m-zeybek/DPC-Hardware-Project/README.md

# DPC-Hardware-Project
EE464 Hardware Project Repo
