m-zeybek/DPC-Hardware-Project/Final Report/main.tex

\documentclass{article}

\usepackage{amsmath}
\usepackage{natbib}
\usepackage{graphicx}
\usepackage{siunitx}
\usepackage{float}
\usepackage{hyperref}
\newcommand\tab[1][1cm]{\hspace*{#1}}
\date{} 
\begin{document}

\begin{figure}[!tp]
\vspace{-10mm}
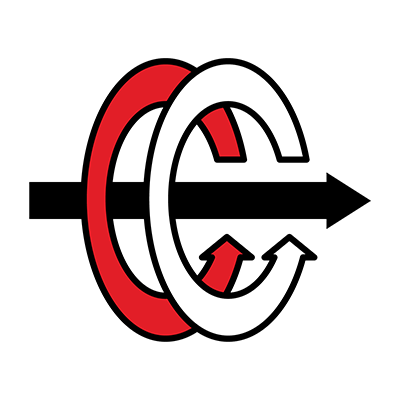
[picture p1: Final Report/ee.png]


\vfil
\hfil \Large \bf MIDDLE EAST TECHNICAL UNIVERSITY
 \hfil
\vfil

\vspace{5mm}
\vfil
\hfil \large \bf  EE464- STATIC POWER CONVERSION-II
 \hfil
\vfil

\vspace{5mm}
\vfil
\hfil \large \bf HARDWARE PROJECT FINAL REPORT \hfil
\vfil
\bf

\vspace{23mm}
Mert ZEYBEK    \tab\tab 2167682

Hamza SOLAK \tab\tab2263762

\vspace{5mm}
\small Date: 24/06/2020

\end{figure}

\newpage

\tab\tab
\section*{Introduction}
\tab In this project, we aimed to design a regulated and isolated DC-DC power supply using Forward Converter topology. This report contains detailed simulation results of our Forward Converter design, PCB design and 3D view of this design, component selection, bill of materials of component selection and thermal equivalent circuit of our design is provided. Basic circuitry and specifications of the Forward Converter is given below:
\begin{figure}[h]
    \centering
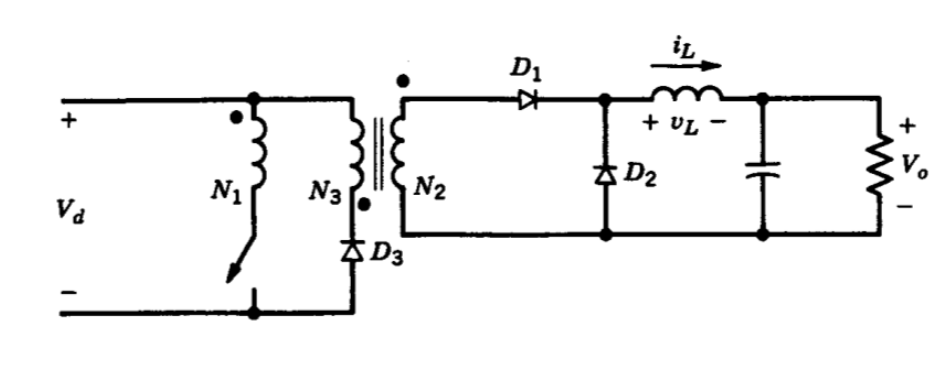
[picture p2: Final Report/forwardconverter.PNG]
    
    \caption{Forward converter circuit schematic }
    \label{fig:my_label}
\end{figure}

\begin{center}
Table 1: Project Design Specifications of Forward Converter
\newline \\

 \begin{tabular}{||c c||} 
 \hline
 Minimum Input Voltage & 12V \\ 
 \hline
 Maximum Input Voltage & 24V  \\
 \hline
 Output Voltage & 10V  \\
 \hline
 Output Power & 48 W  \\
 \hline
 Output Voltage Peak to Peak Ripple & 2 \% \\
 \hline
  Line Regulation & 2 \% \\
 \hline
  Load Regulation & 2 \% \\
 \hline
 \end{tabular}
 \end{center} \\
 
 \tab Considering that using Forward Converter topology instead of Flyback Converter increases cost, we aimed to come up with a more efficient converter instead of cheaper converter since using this topology already increases cost and it may not be possible to offer cheapest solution to the customers. Minimizing volume also was not our primary concern since the topology has transformer which makes its volume larger than non-isolated converter topologies such as Buck converter, Cuk converter.
 
\newpage
\section*{Design Decisions}
\tab Since we aim to make our circuit as efficient as possible, some of the design decisions that we took in the Simulation Report are revised. We tried to make core loss and copper loss of magnetizing elements as close as possible since we assume it is the ideal and most efficient case. Semiconductor devices are also revised to minimize losses on them.
\subsection*{1) Magnetic Design}
\tab\textbf{a) Transformer Design} \\
\tab Firstly, we selected our switching frequency. We selected it as 10 kHz. Although it is relatively small value for that kind of application, it decreases losses which is our main goal. Then we calculated our desired area product for the transformer considering our design specifications as follows, where $P_{out}$ is output power, J is current density, K is topology constant, $B_{max}$ is maximum flux density and f is frequency:

 \begin{equation*}
     W_aA_c=\frac{P_{out}J}{K B_{max} f}=\frac{48*500}{0.0005*1300*10*10^3}=3.69 cm^4
 \end{equation*}
 \tab Since we desire to have a high permeability core for Forward Converter, ferrite cores fit better for our application. Considering these, \href{https://www.mag-inc.com/Media/Magnetics/Datasheets/0P44022EC.pdf}{0P44022EC} is selected. It is an E shaped, P material type ferrite core, whose area product is $4.59 cm^4$. Its geometric shape is given below:
 \begin{figure}[H]
    \centering
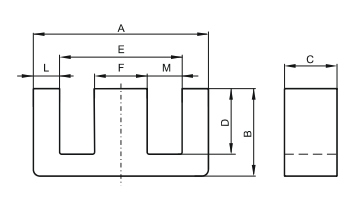
[picture p3: Final Report/transformer.PNG]
    
    \caption{Geometric Shape of Transformer Core}
    \label{fig:my_label}
\end{figure}
 \tab After that, we calculated our required primary number of turns for the transformer as follows:
 \begin{equation*}
    n_1>\frac{V_i_{max}*D_{max}}{f_s*B_{sat}*A_e}=\frac{24*0.5}{10^4*0.3*0.000233}=17.167
\end{equation*}
$n_1$ is selected as 18. Considering we always need to stay below 0.5 duty cycle so that we do not saturate the core and considering additional voltage losses in realistic simulation, we calculated $n_3$ $ \frac{n_3}{n_1}=1.2$. As a result, $n_3$ is initially selected as 22. On the other hand, later simulation results with non-idealities showed that this turn ratio causes duty cycle to go over 0.5 in minimum input voltage, 24 V. As a result, it is adjusted as 40, according to simulation results. $n_2$ is selected as 18 as well, equal to $n_1$. After that, appropriate cable sizes are selected for each winding for current density of $4 A/mm^2$. Maximum input current is assumed to be 2.08 A and output current is assumed to be 5 A considering power and voltage ratings. As a result, AWG18 for primary side, AWG14 for secondary side and AWG25 for reset winding is selected. Fill factor is calculated to whether we can fit these cables inside the core or not as follows:
\begin{equation*}
    k_f=\frac{A_{cable}}{A_e}=\frac{((18*0.82+39*2.08+18*0.16) mm^2}{233 mm^2}=0.424
\end{equation*}
Fill factor is relatively small, on the other hand it shows that cables can fit into the core and having a large core can help us reduce core losses. \\
\tab Copper losses are calculated with selected cable sizes. To do that, mean length per turn value was necessary, which is calculated as below for E shaped transformer:
\begin{equation*}
    MLT=\frac{ \pi*(E-F)}{4}= 13.59 mm
\end{equation*}

After that, primary and secondary winding resistances are found as follows:

\begin{equation*}
    R_{1}=20.9428*18*13.59*10^{-6}=5.123 mOhms
\end{equation*}

\begin{equation*}
    R_{3}=8.282*40*13.59*10^{-6}=4.502 mOhms
\end{equation*}

Using $I^2R$ formula, copper loss is calculated as follows:
\begin{equation*}
    P_{copper}=I_1^2R_1+I_3^2R_3=2.08^2*5.123*10^{-3}+5^2*4.502*10^{-3}=134 mW
\end{equation*}

\tab To calculate core loss, Steinmetz's Equation is used. It is specified as follows:
\begin{equation*}
    P_{CL}=\frac{a*f^x*B^y*L(T)}{1000} mW/cm^3
\end{equation*}
\tab To use this equation, a, x and y constants, which are material specific, are needed. For P type material Magnetics provided these values as $a=3.2$, $x=1.46$ and $y=2.75$. L(T) is also a function of ambient temperature and it is given as $1$ for $100 Celcius$ temperature. It is assumed to be 1 in the calculation:
\begin{equation*}
     P_{CL}=\frac{3.2*(10*10^3)^{1.46}*0.3^2.75}{1000}=137.91 mW/cm^3
\end{equation*}
Multiplying it with $V_e$ of the core which is $5590 mm^3$, we can find $P_{core}$ as follows:

\begin{equation*}
   P_{core}=P_{CL}*V_e=137.91*5.59=770.92 mW
\end{equation*}

\tab Lastly, to find magnetizing inductance of the transformer, following equation is used:

\begin{equation*}
    L_m=A_L N^2=5000 nH*(40+18*2)^2=28.88 mH
\end{equation*}

\tab\textbf{b) Inductor Design}
\newline \tab At inductor design, we want to limit output current ripple which would also ensure continuous conduction mode. We want to keep the converter in CCM since forward converter's gain changes a lot in DCM. On the other hand, choosing a too large inductor would increase DCR value, which would reduce efficiency. We considered following equations for calculation of our output inductor considering 2 \% ripple rating:
\begin{equation*}
    I_{L_O,min}=I_{O,max}*0.02 =4.8*0.02=0.096 A
\end{equation*}
Ripple value must be less than twice of this value which is given below:
\begin{equation*}
{\displaystyle \Delta }I_{L_o}=(\frac{n_3}{n_1}*V_i-V_o)*\frac{1}{L_o}*t_{on}<0.192 A
\end{equation*}
\tab As a result, we need an inductor with $3.8 mH$ inductance in order to meet criteria. This value is relatively high since our switching frequency is small. As a result, we needed to select a core with high inductance per turn square value. Using \href{https://www.mag-inc.com/getattachment/Products/Ferrite-Cores/Learn-More-about-Ferrite-Cores/Magnetics-Ferrite-Catalog-2017.pdf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}{this} catalog of Magnetics, \href{https://www.mag-inc.com/Media/Magnetics/Datasheets/0W44715TC.pdf}{0W44715TC} is selected as our inductor core. Its geometric shape is given below:
\begin{figure}[H]
    \centering
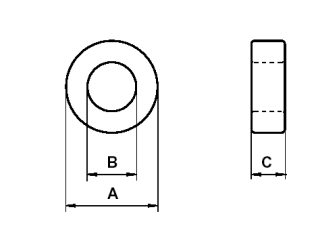
[picture p4: Final Report/inductor.PNG]
    
    \caption{Geometric Shape of Inductor Core}
    \label{fig:my_label}
\end{figure}
Its $A_L$ value is defined as $16100 nH/T^2$ at 10 kHz, which is our switching frequency. Number of turns is calculated as follows:
\begin{equation*}
    N=10^3*\sqrt\frac{L}{A_L}=10^3*\sqrt\frac{3.8 mH}{16100 nH}=15.36 \approx 16 turns
\end{equation*}
Assuming it will carry more or less same amount of current with the secondary winding of the transformer, we can choose AWG14 cable for inductor as well.Fill factor according to these selection is calculated below:
\begin{equation*}
    K_f=\frac{A_{cond}}{W_a}=\frac{2.08*16}{145}=0.230
\end{equation*}
After that, length of cable that is going to used for inductor is necessary to determine copper loss on the inductor. 

\begin{equation*}
    MLT=(A-B)+2C=49.9 mm
\end{equation*}

\begin{equation*}
    P_{copper}=I^2R=4.8^2*8.282*16*49.9*10^{-6}=317 mW
\end{equation*}
\tab To find core losses, Steinmetz's Equation is used once more.  According to that, core loss is calculated below:
\begin{equation*}
    P_{core}=V_e*a*B^b*f^c=16.063*10^{-3}*31.320*0.3^{1.585}*40^{1.371}=44.26 mW
\end{equation*}
\subsection*{2) Closed Loop Control}
\tab Since we desire to have a constant output voltage with variable input voltage, we need to have a closed loop controller. To do that, we used TL494 integrated circuit. Its pin output is given below:

\begin{figure}[H]
    \centering
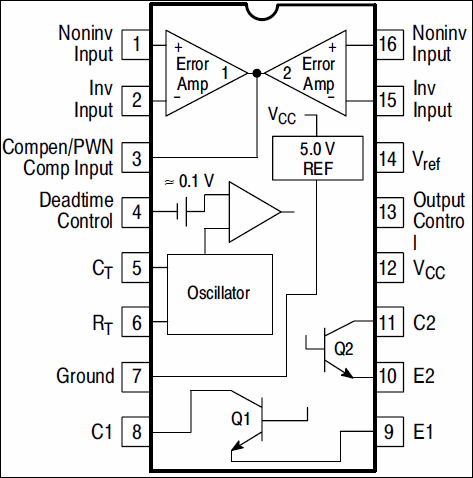
[picture p5: Final Report/tl494.png]
    
    \caption{TL494 Pin Output Diagram}
    \label{fig:my_label}
\end{figure}

\tab First thing to do while deciding our parameters was setting oscillation frequency equal to our selected switching frequency, which is 10 kHz. $R_T$ and $C_T$ values are calculated according to the following formula:

\begin{equation*}
    f_s=\frac{1}{R_TC_T}
\end{equation*}
$C_T$ is selected as 1 nF and $R_T$ is selected as 100 kOhms.  \\
After that, we moved to Error Amplifier circuit in order to keep output voltage constant, whose schematic is given below:

\begin{figure}[H]
    \centering
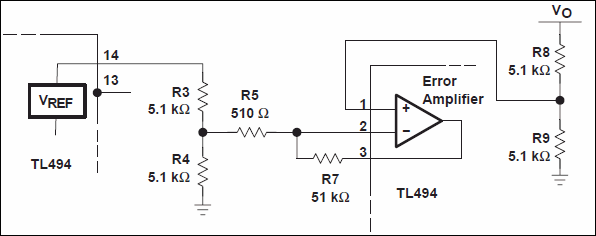
[picture p6: Final Report/error.png]
    
    \caption{TL494 Error Amplifier Circuit}
    \label{fig:my_label}
\end{figure}

\tab In this circuitry, $R_3$ and $R_4$ resistances create a reference voltage of 2.5 V. $R_8$ and $R_9$ enables us to sample our output voltage and $R_5$ and $R_7$ determines the gain of the amplifier. We decided to stick to resistance values that were given in the example circuit given above, since they meet our requirements. From the TL494 schematic, we can see that there are two error amplifiers in this circuit. However, the other amplifier is usually used for current limiting, which we do not want to have in this case. As a result, we decided to connect its positive input to supply voltage and negative input to ground, so that we never limit the current. \\

\tab After that, we moved on to soft start future of TL494, which can be helpful in limiting stresses on the devices by avoiding high starting currents. Soft start circuit of TL494 is given below:

\begin{figure}[H]
    \centering
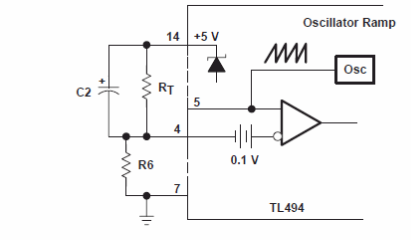
[picture p7: Final Report/soft.PNG]
    
    \caption{TL494 Soft Start Circuit}
    \label{fig:my_label}
\end{figure}

\tab Soft start time is selected as 15 ms, which is 150 cycles period for 10 kHz frequency. According to that, $C_2$ is selected as 3.3 uF AND $R_6$ is selected as 4.7 kOhms. \\

\tab TL494 is good at creating the PWM signal that we desire. However, it cannot drive a MOSFET directly with its output signal. Considering this, we decided to use an TLP250 digital optocoupler. It also creates isolation between high voltage part and low voltage part of the circuit, which is another advantage. TLP250 circuit is given below:

\begin{figure}[H]
    \centering
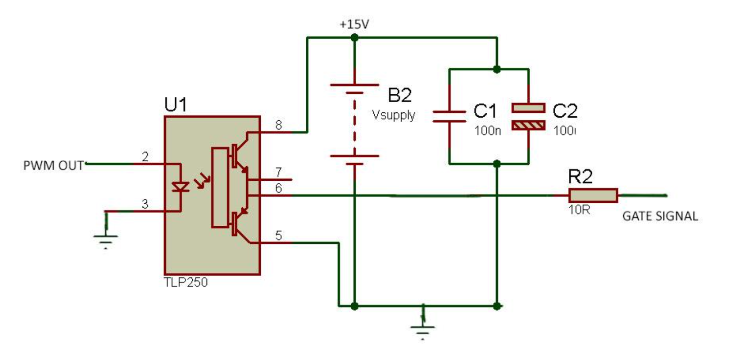
[picture p8: Final Report/opto.PNG]
    
    \caption{TLP250 Digital Optocoupler Circuit}
    \label{fig:my_label}
\end{figure}
\tab We needed an another optocoupler in order to isolate output from the controller circuit. We decided to use TLP521 for this purpose. Its pin diagram is given below:
\begin{figure}[H]
    \centering
    
    \caption{TLP521 Analog Optocoupler Pin Diagram}
    \label{fig:my_label}
\end{figure}

\newpage
\section*{Simulation Results and Component Selections}
\tab Component selection that was done in the Simulation Report is revised since it was based on ideal Forward Converter Simulink model and hence voltage and current ratings of the components were too strict. As a result, new components are selected with higher ratings and their characteristics are put in the non-ideal Simulink model. Calculated magnetizing inductance and leakage inductance of the transformer, resistances of the windings, voltage drops on the semiconductors, resistance of the inductor and capacitor are added to the model and stress on the components are checked once again in order to verify that components can operate properly in the circuit. Simulink model of the converter is given below:
\begin{figure}[H]
    \centering
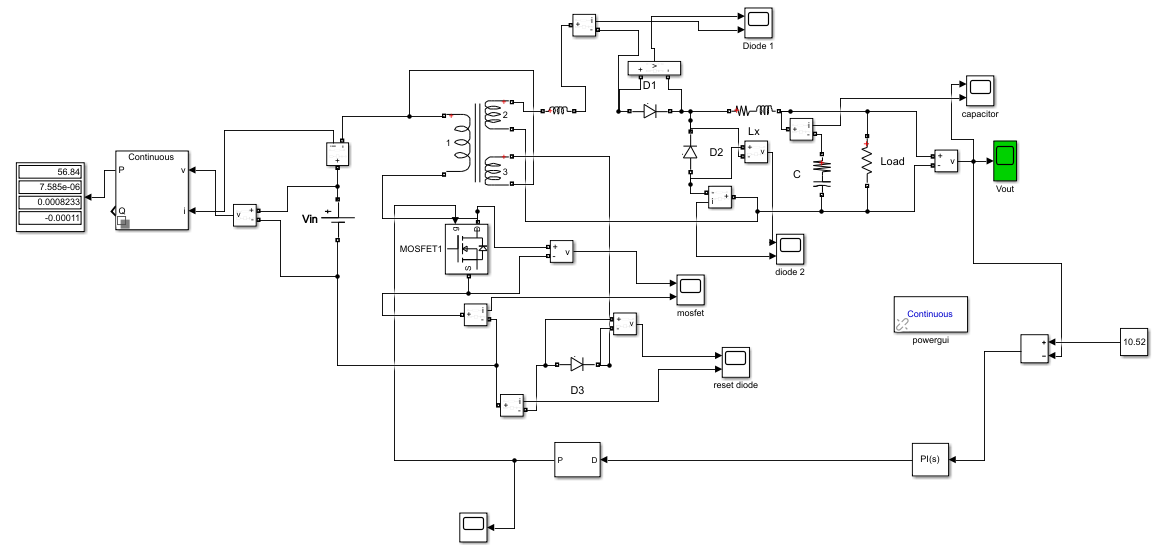
[picture p9: Final Report/non ideal simulink.PNG]
    
    \caption{Simulink Model of the Forward Converter with Non-Idealities}
    \label{fig:my_label}
\end{figure}
\tab The circuit is simulated for two extreme cases, having 24 V input and 48 V input. Output voltage waveform for these cases are given below:
\begin{figure}[H]
    \centering
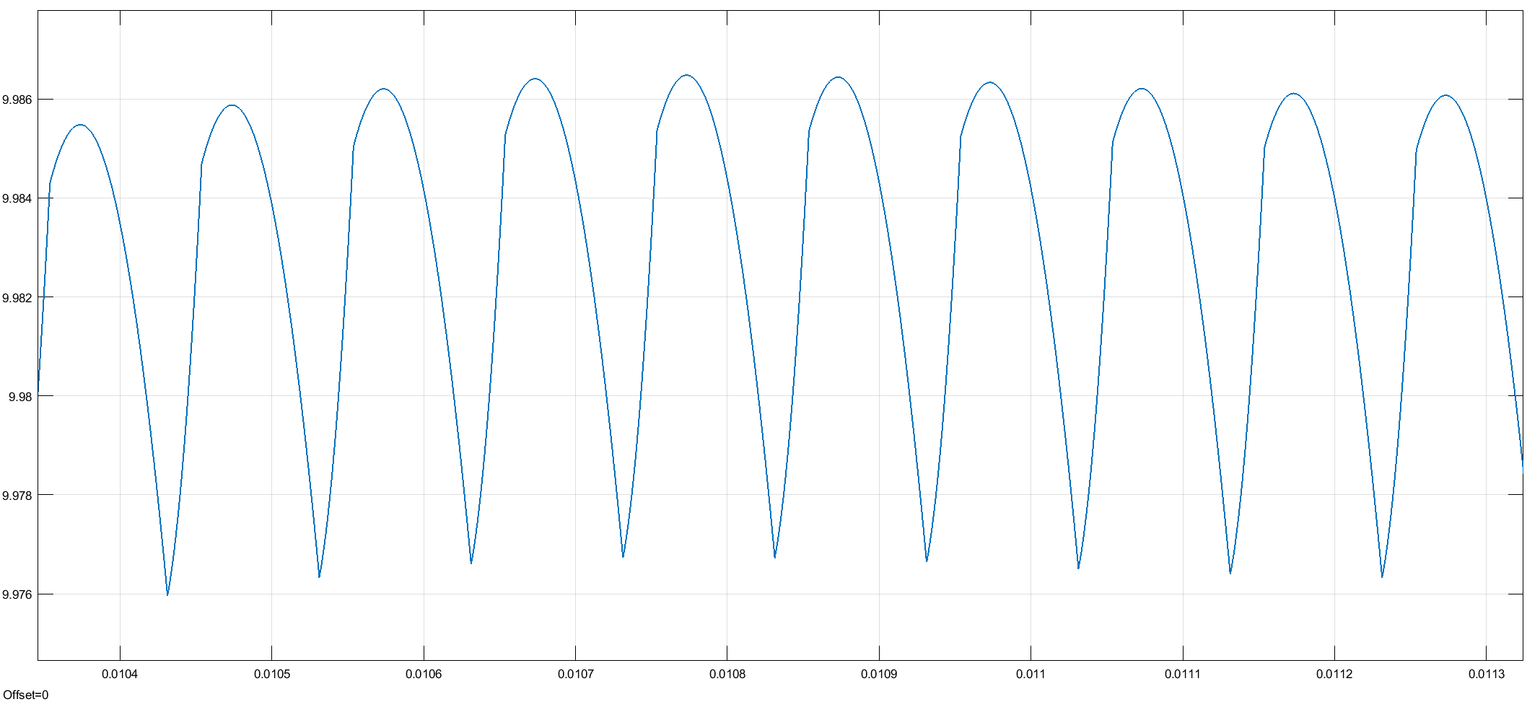
[picture p10: Final Report/24v_output.png]
    
    \caption{Output Voltage Waveform when Input Voltage is 24 V}
    \label{fig:my_label}
\end{figure}

\begin{figure}[H]
    \centering
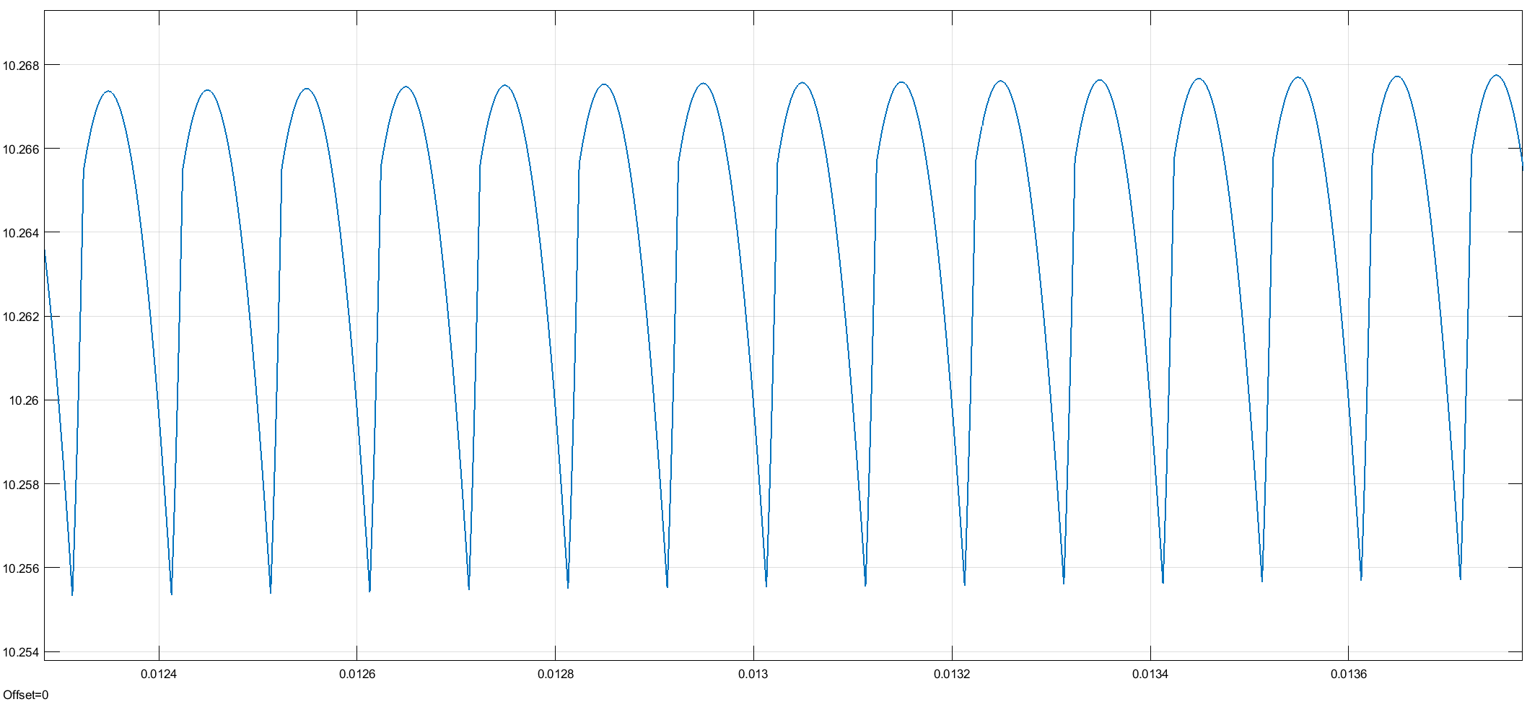
[picture p11: Final Report/48v_output.png]
    
    \caption{Output Voltage Waveform when Input Voltage is 48 V}
    \label{fig:my_label}
\end{figure}
\tab For 24 V input, peak to peak voltage ripple is 0.0101 V, which corresponds to $0.1 \%$ and it is 0.01242 V for 48 V input which is also very close to $0.1 \%$ ripple percentage, easily meeting the criteria. 

\tab Input current waveforms are also given for both input voltage cases below:
\begin{figure}[H]
    \centering
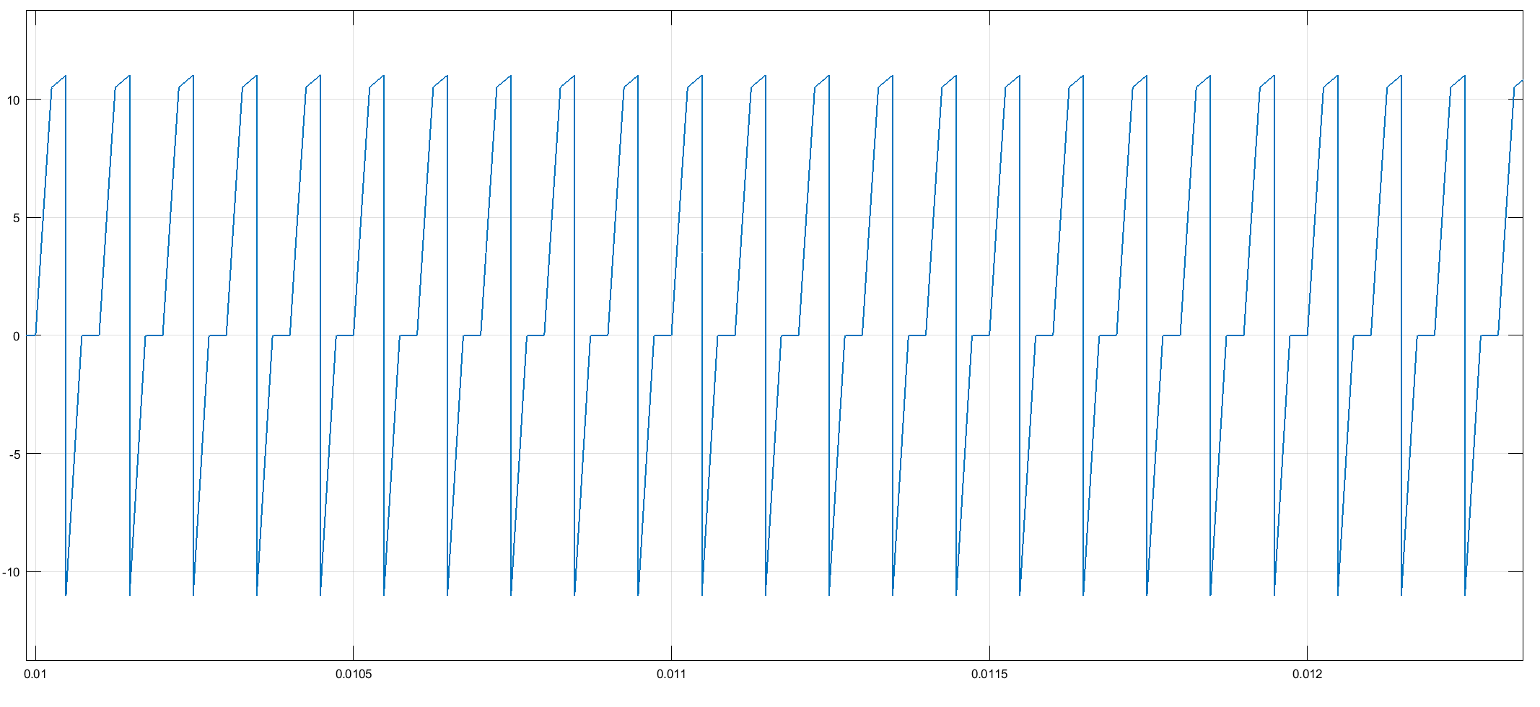
[picture p12: Final Report/24v_input current.png]
    
    \caption{Input Current Waveform when Input Voltage is 24 V}
    \label{fig:my_label}
\end{figure}

\begin{figure}[H]
    \centering
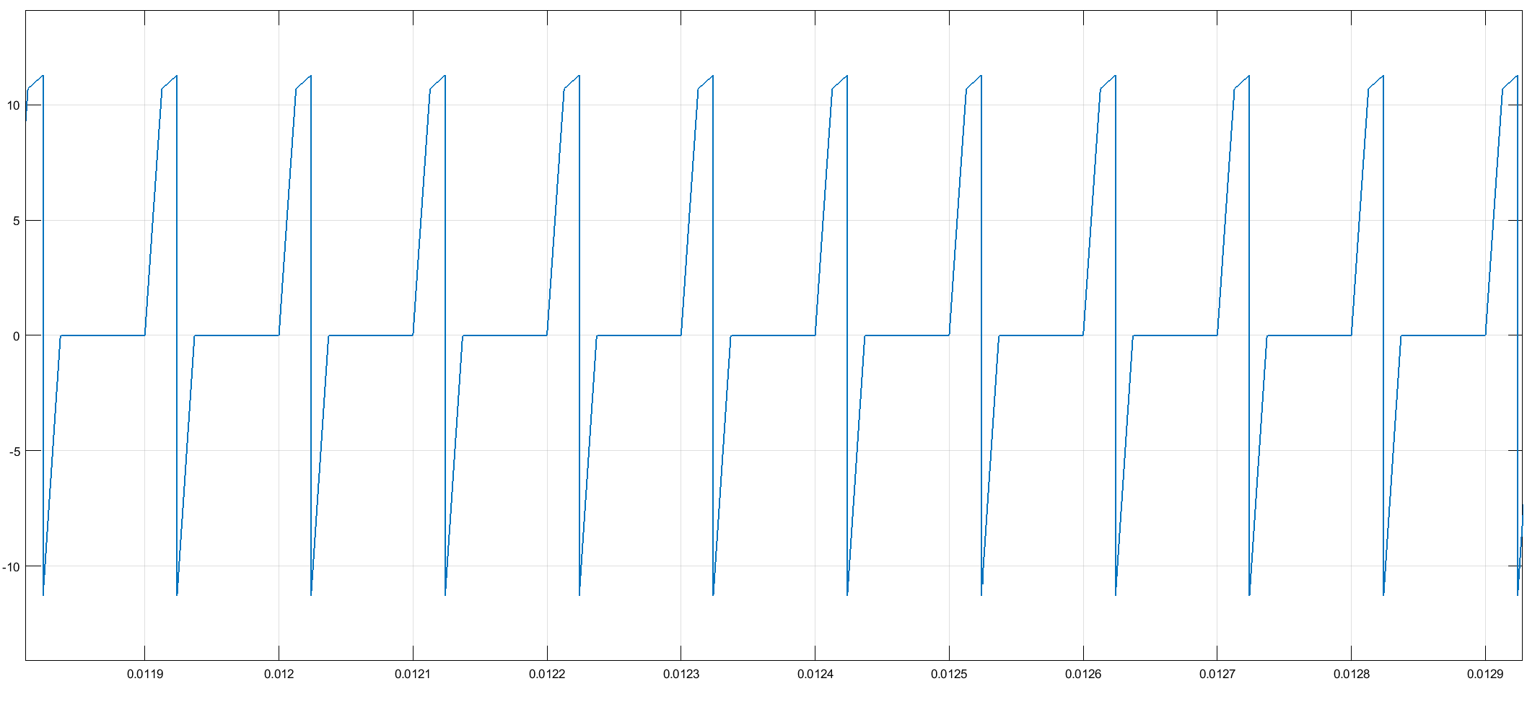
[picture p13: Final Report/48v_input current.png]
    
    \caption{Input Current Waveform when Input Voltage is 48 V}
    \label{fig:my_label}
\end{figure}

\tab After that, load resistance is changed from 2.08 Ohms to 20.8 Ohms to check voltage deviation with respect to previous case with 24 V input. It could not be done dynamically, changing resistance during the simulation, since variable resistor is not included in Power Systems library in Simulink. Output voltage waveform for this case is given below:
\begin{figure}[H]
    \centering
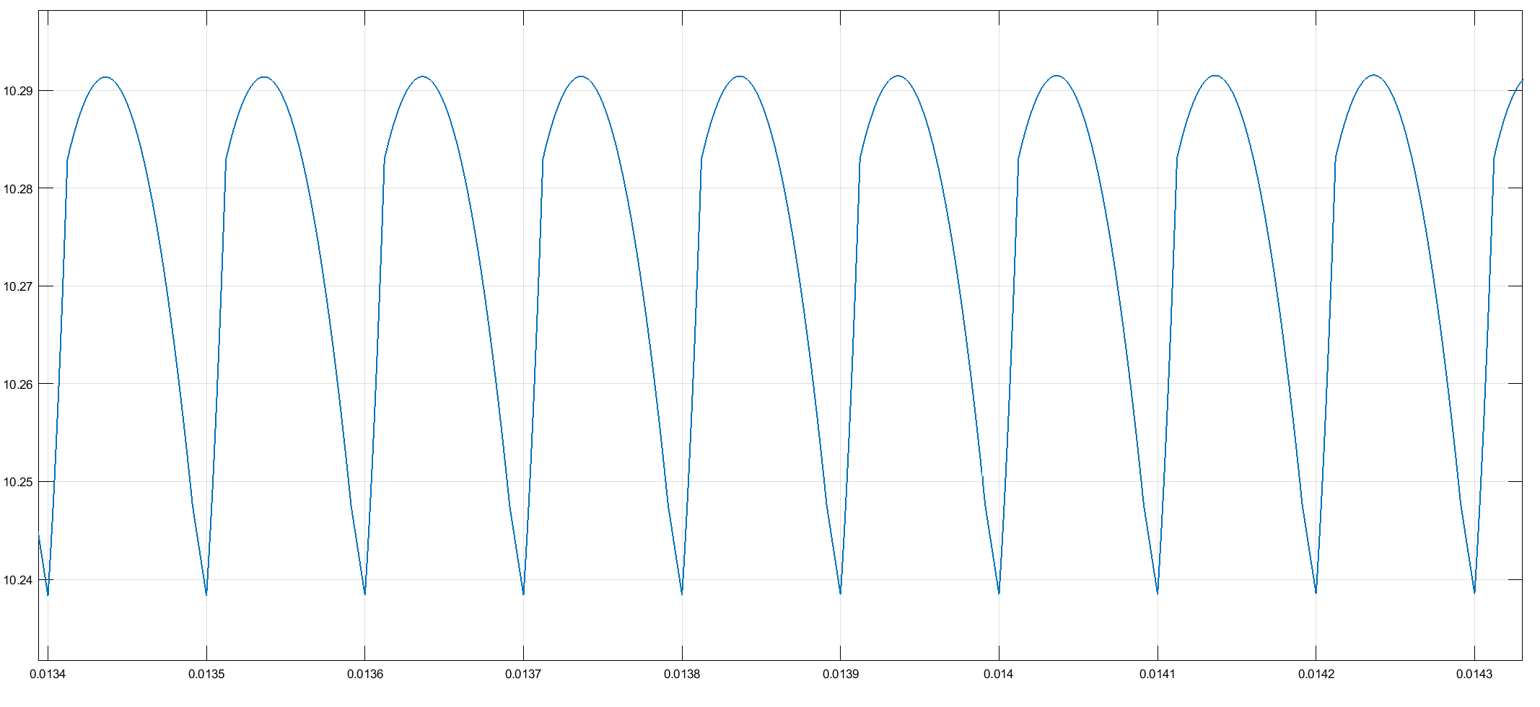
[picture p14: Final Report/24v_output with higher load.png]
    
    \caption{Output Voltage Waveform when Load Resistance is Increased}
    \label{fig:my_label}
\end{figure}

The RMS value of output voltage is decreased from 10.05 V to 10.02 V, meeting the load regulation criterion.

\tab In order not to saturate the transformer core, we need to have maximum 50 \% duty cycle at most. When the input is 24 V, we had our maximum duty cycle, which was 47.801 \%. For 48 V input voltage, duty cycle was at 25.217 \%. Graphs of duty cycle for both cases are provided below:
\begin{figure}[H]
    \centering
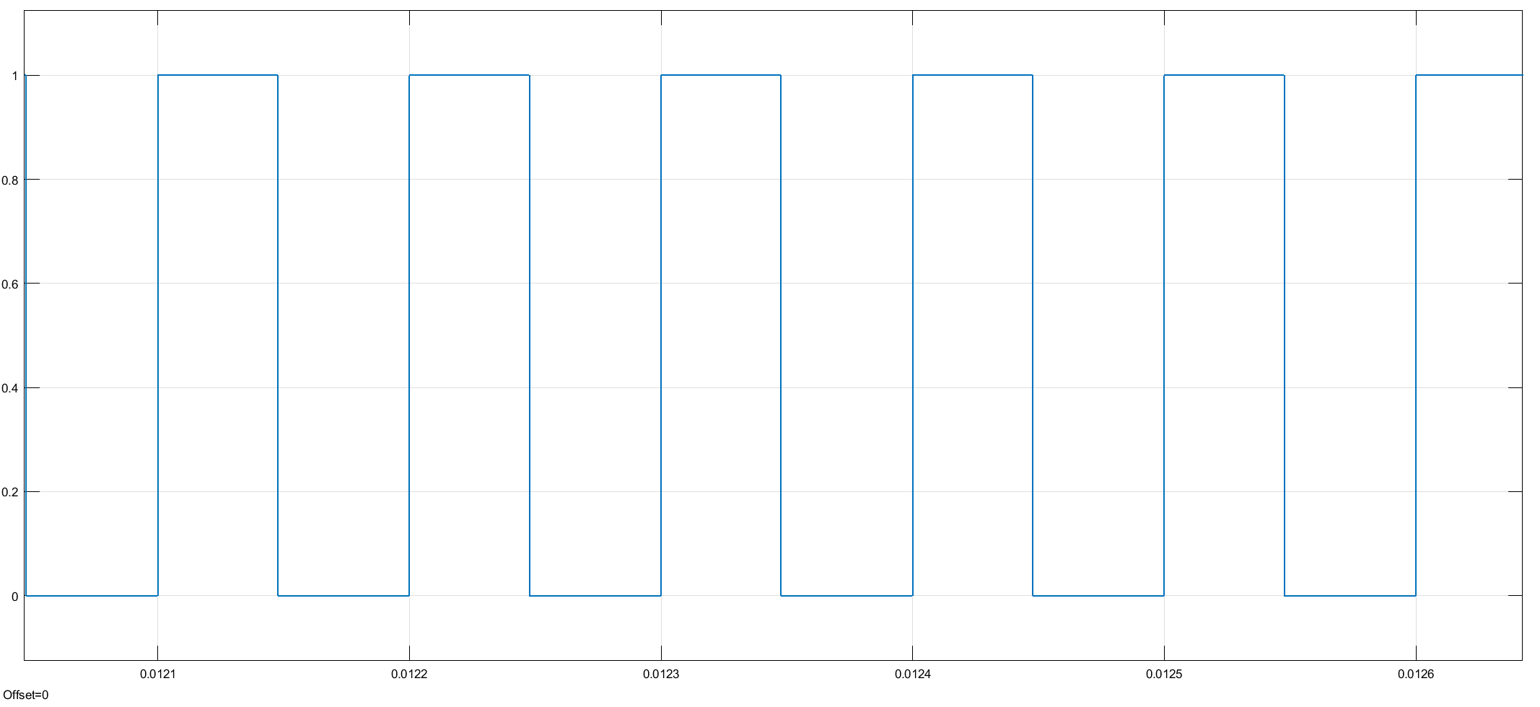
[picture p15: Final Report/24v_duty.png]
    
    \caption{Duty Cycle Waveform when Input is 24 V}
    \label{fig:my_label}
\end{figure}

\begin{figure}[H]
    \centering
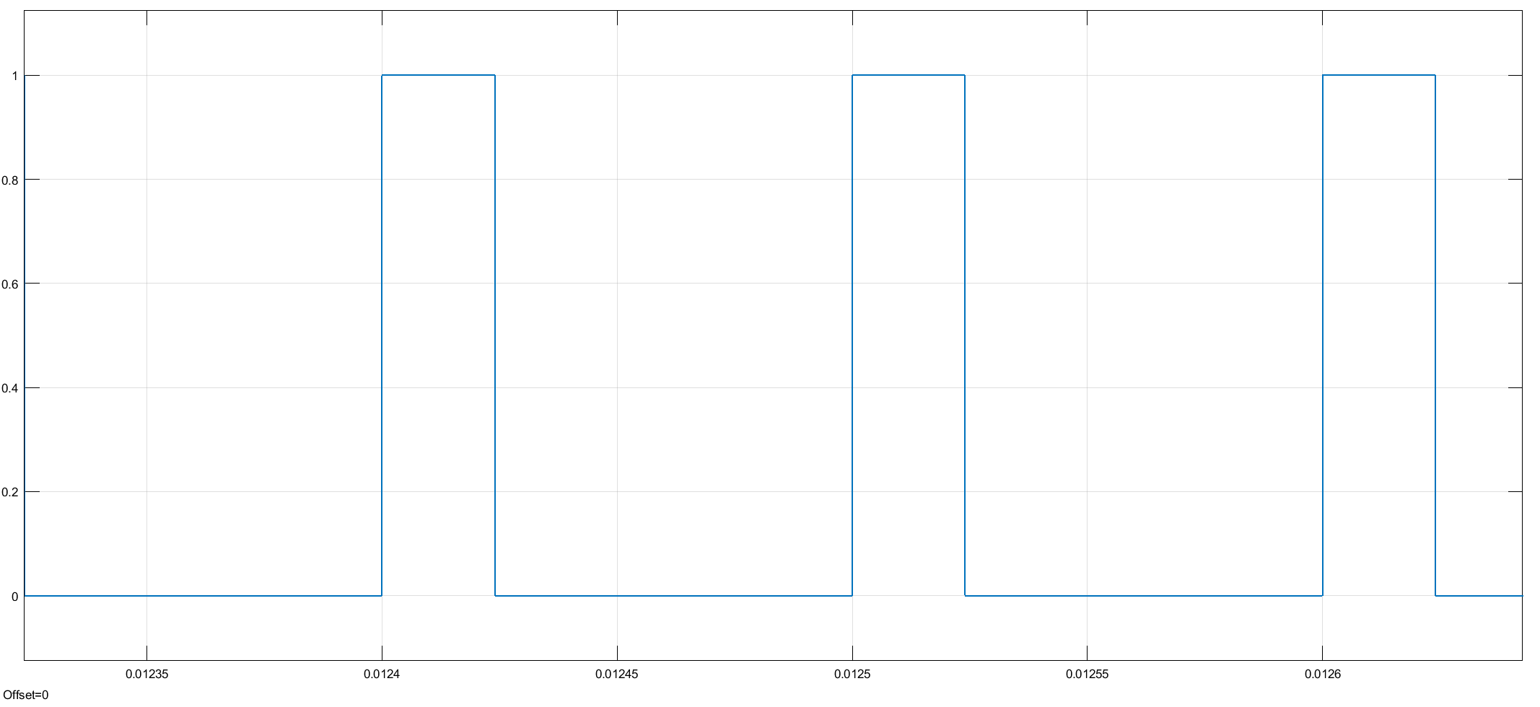
[picture p16: Final Report/48v_duty.png]
    
    \caption{Duty Cycle Waveform when Input is 48 V}
    \label{fig:my_label}
\end{figure}

\tab For MOSFET, \href{http://www.irf.com/product-info/datasheets/data/irf5y31n20.pdf}{IRF5Y31N20} is selected. It has 200 V drain to soure breakdown voltage, 18 A drain current, 1.3 V internal diode forward voltage and 0.092 Ohms $R_{DS}$ resistance. It has 148 ns rise time and 27 ns fall time, which is fine for our switching frequency. It can handle the stresses and it also has low drain to source resistance which is good for the efficiency. Graphs of MOSFET voltage and current for both cases are given below:

\begin{figure}[H]
    \centering
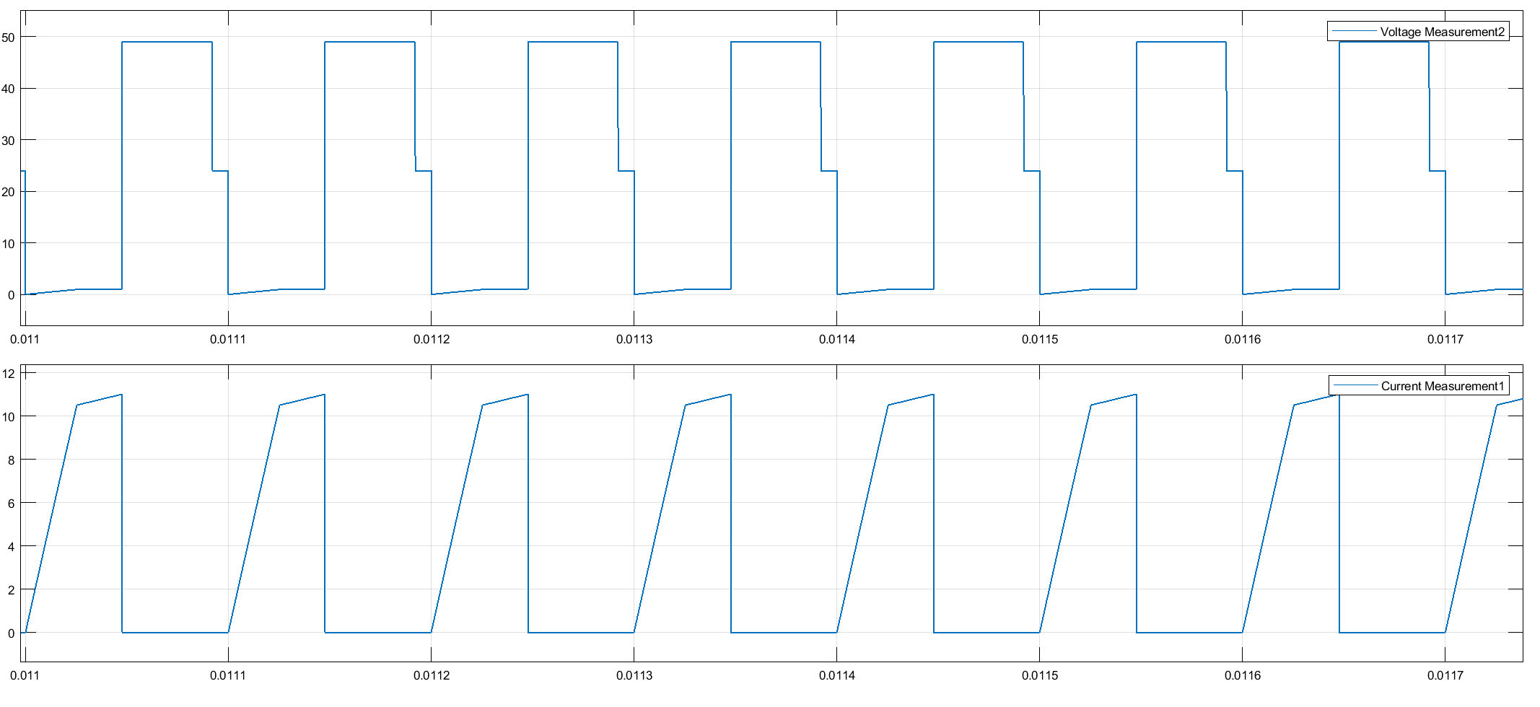
[picture p17: Final Report/24v_mosfet.png]
    
    \caption{MOSFET Voltage and Current when Input is 24 V}
    \label{fig:my_label}
\end{figure}

\begin{figure}[H]
    \centering
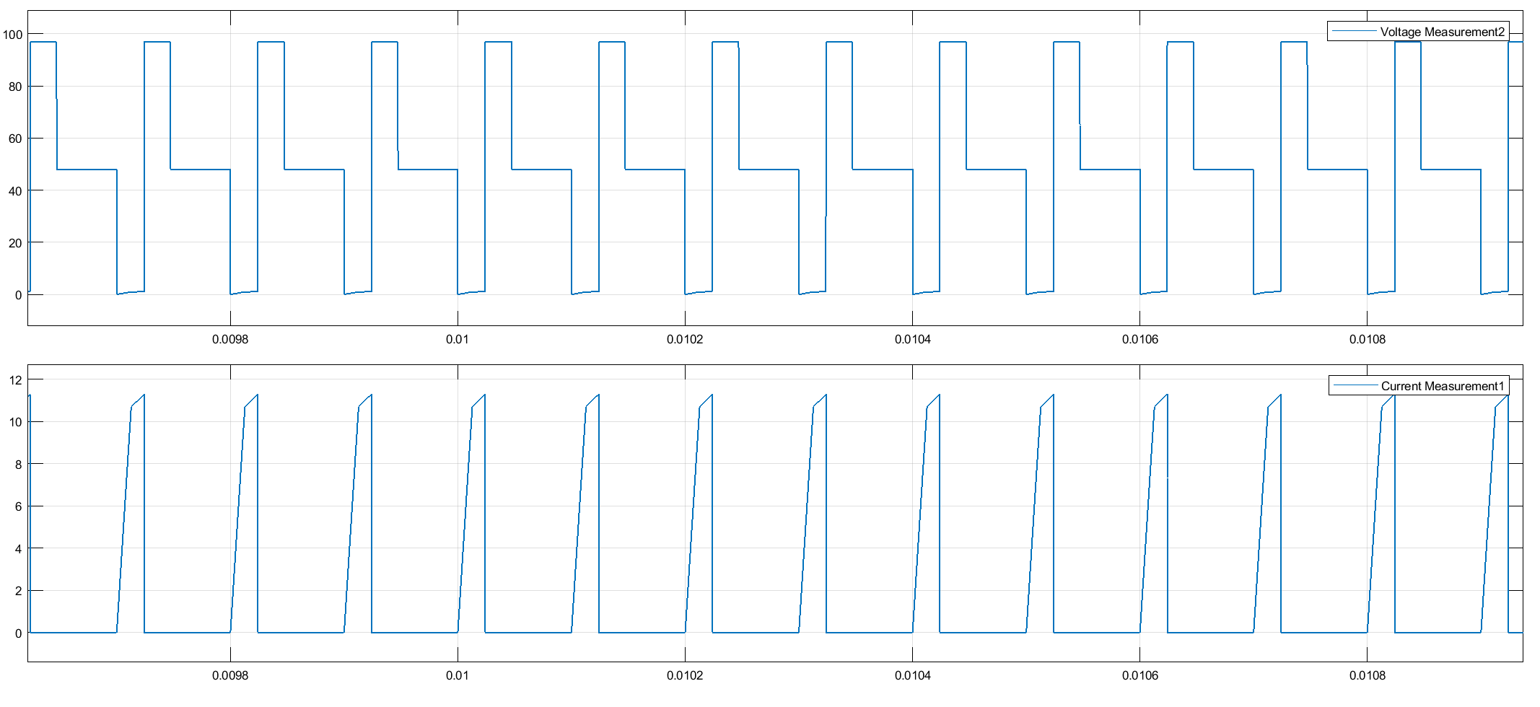
[picture p18: Final Report/48v_mosfet.png]
    
    \caption{MOSFET Voltage and Current when Input is 48 V}
    \label{fig:my_label}
\end{figure}
It carries 11 A peak current and its maximum voltage is less than 100 V. As a result, it can handle these stresses. Its picture is also given below:\\
\begin{figure}[H]
    \centering
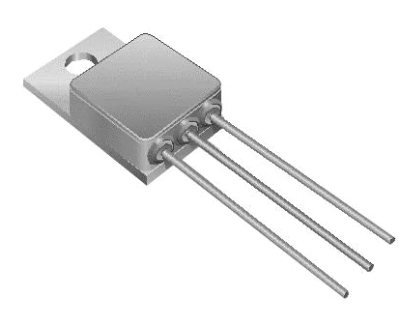
[picture p19: Final Report/mosfet.PNG]
    
    \caption{Picture of the MOSFET}
    \label{fig:my_label}
\end{figure}
\tab For reset diode, \href{https://www.taiwansemi.com/products/datasheet/SFAF501G\%20SERIES_H1512.pdf}{SFAF503GHC0G} is selected. It has 150 V blocking voltage and 0.975 V voltage drop on it. It can carry up to 5 A average current and 125 A peak current with 35 ns maximum reverse recovery time. Graphs of diode voltage and current for both cases are given below with the picture of diode:
\begin{figure}[H]
    \centering
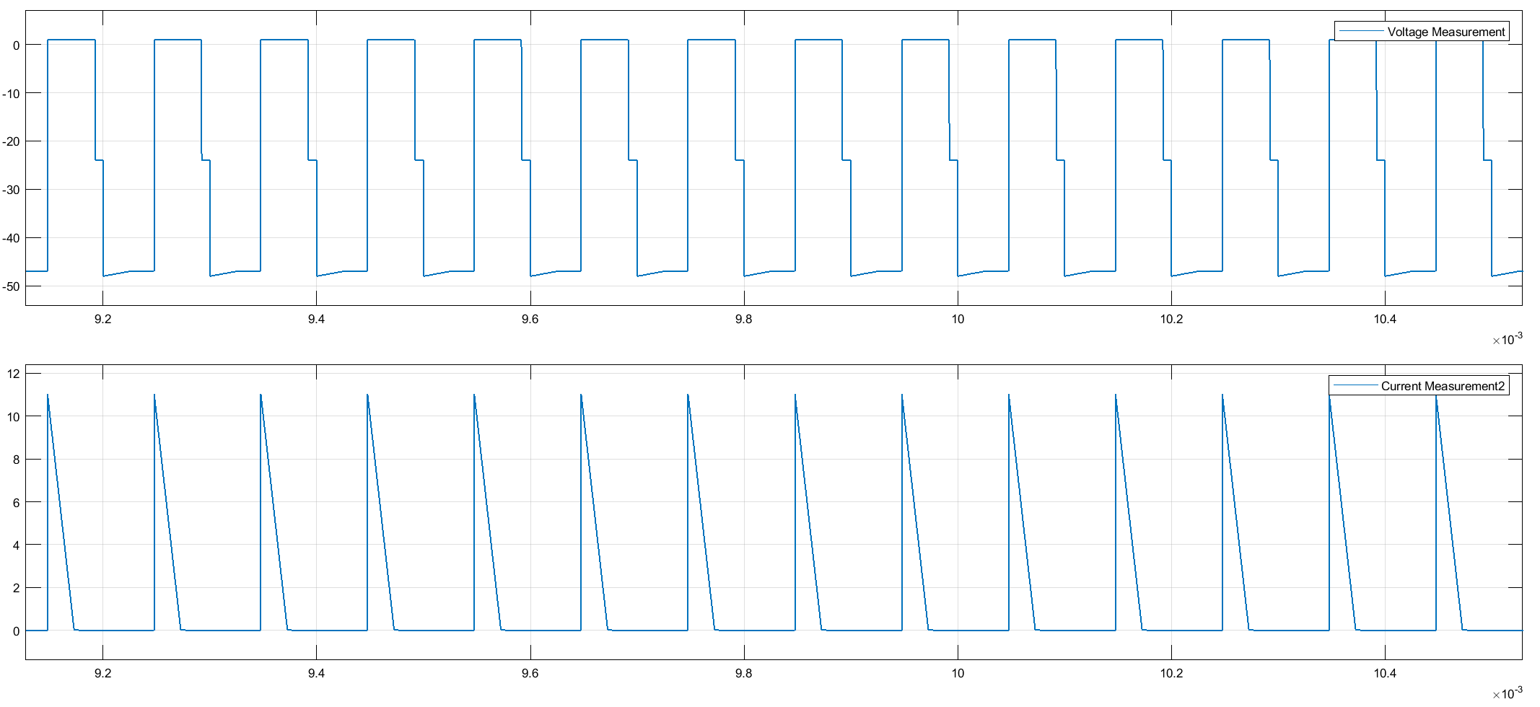
[picture p20: Final Report/24v_reset diode.png]
    
    \caption{Reset Diode Voltage and Current when Input is 24 V}
    \label{fig:my_label}
\end{figure}

\begin{figure}[H]
    \centering
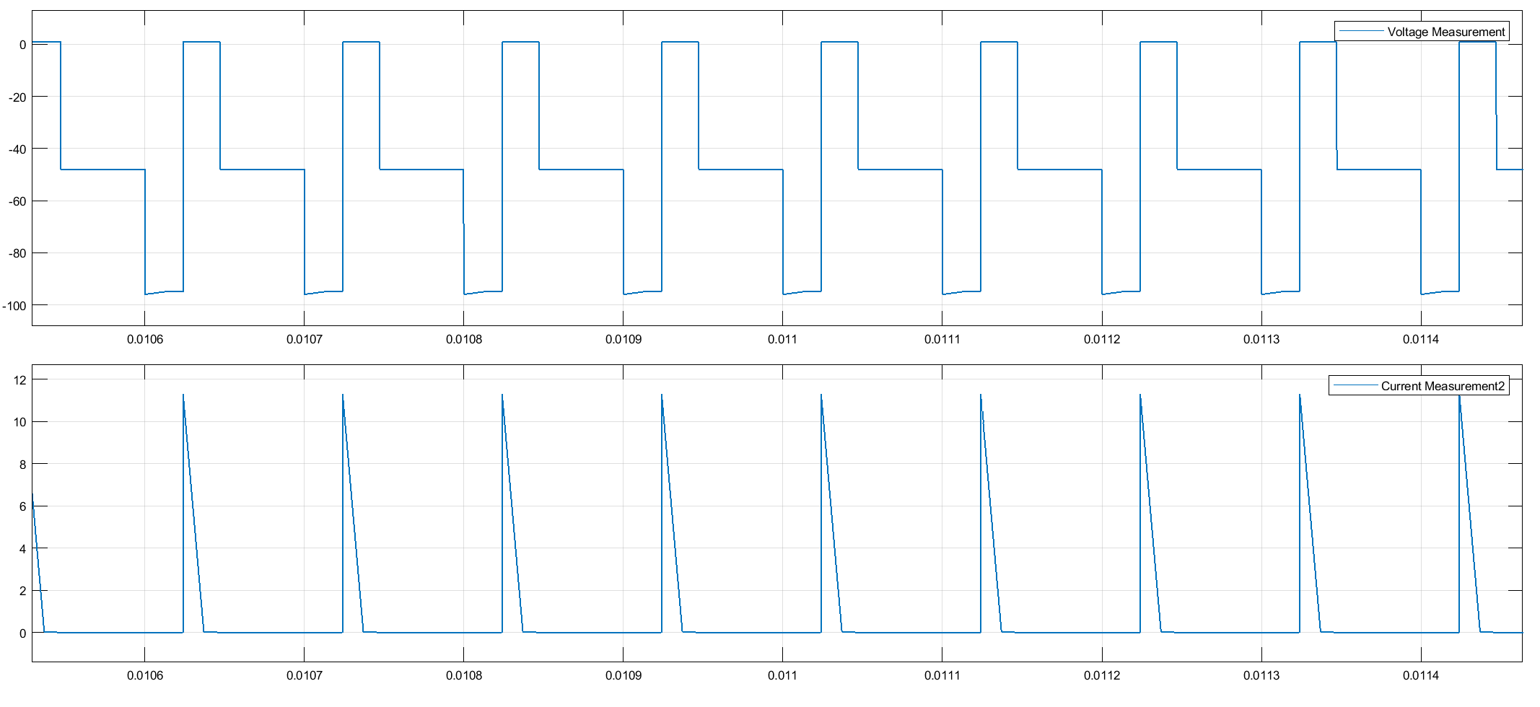
[picture p21: Final Report/48v_reset diode.png]
    
    \caption{Reset Diode Voltage and Current when Input is 48 V}
    \label{fig:my_label}
\end{figure}

\begin{figure}[H]
    \centering
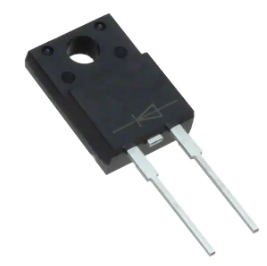
[picture p22: Final Report/reset diode.PNG]
    
    \caption{Picture of the Reset Diode}
    \label{fig:my_label}
\end{figure}
For secondary side diodes, \href{https://www.taiwansemi.com/products/datasheet/SRA1020\%20SERIES_J13.pdf}{SRA10150 C0G} is selected. Since it is Schottky diode, it has no recovery problem. It has 0.7 V voltage drop on it. Graphs for secondary side diode voltage and current for both cases and picture of the diode are given below:

\begin{figure}[H]
    \centering
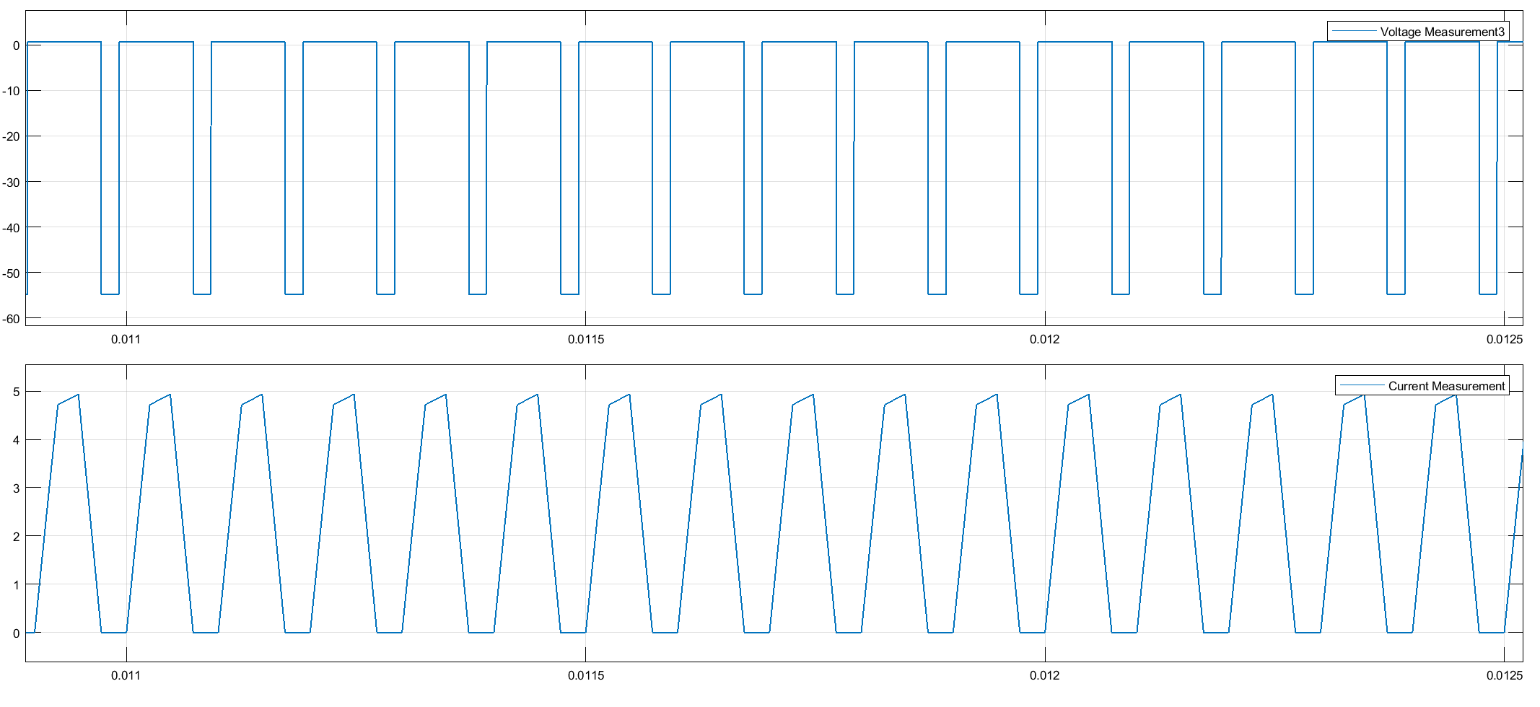
[picture p23: Final Report/24v_secondary diode.png]
     
    \caption{Secondary Diode Voltage and Current when Input is 24 V}
    \label{fig:my_label}
\end{figure}

\begin{figure}[H]
    \centering
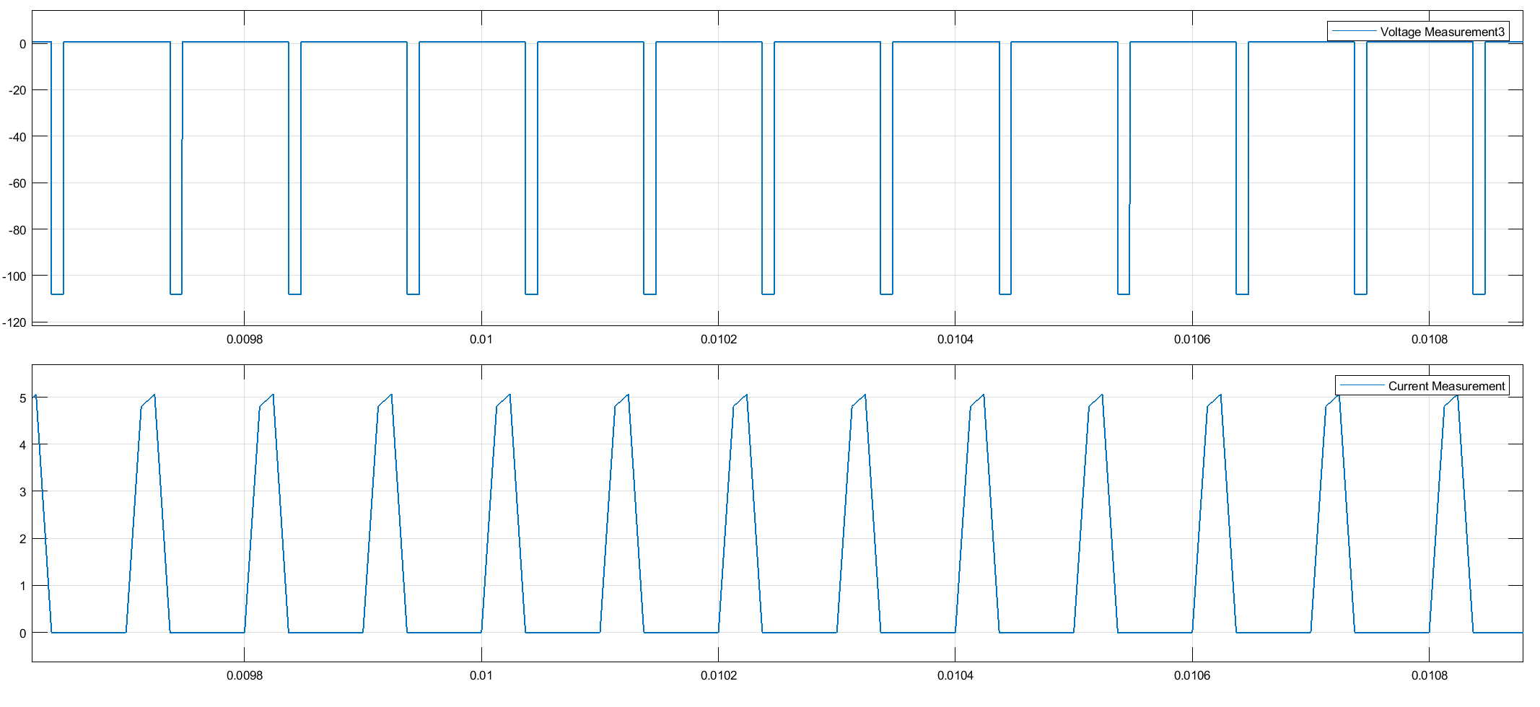
[picture p24: Final Report/48v_secondary diode.png]
    
    \caption{Secondary Diode Voltage and Current when Input is 48 V}
    \label{fig:my_label}
\end{figure}

\begin{figure}[H]
    \centering
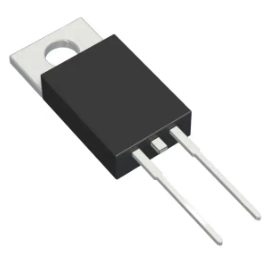
[picture p25: Final Report/schottky.PNG]
    
    \caption{Picture of the Secondary Side Diode}
    \label{fig:my_label}
\end{figure}

\tab For output capacitor, \href{https://api.kemet.com/component-edge/download/specsheet/ESY477M035AH4AA.pdf}{ESY477M035AH4AA} is selected. It is a 470 uF, 35 V capacitor. Although its capacitance is more than we need to achieve our output voltage ripple aim, we chose it due to its small ESR resistance, which is defined as 26 mOhms for 100 kHz. Assuming electrolytic capacitor will have higher ESR value at lower frequency, it is taken as 40mOhms for simulations. Its picture is given below:

\begin{figure}[H]
    \centering
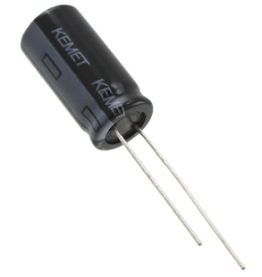
[picture p26: Final Report/capacitor.PNG]
    
    \caption{Picture of the Output Capacitor}
    \label{fig:my_label}
\end{figure}
\section*{Efficiency}
\tab To calculate efficiency from the simulation model, Power Measurement block is used by measuring input and output current and voltages. However, core losses are not included in the simulation model. Hence, their calculated values in Design Decisions section using Steinmetz's Equation are used for transformer and inductor. \\
\tab Firstly, efficiency is tested for 24 V input and 48 V input cases. After that, different load resistance values are used. Results are provided below:

\begin{equation*}
    \eta_{24 V}=\frac{P_{out}}{P_{in}+P_{core}}=\frac{48.62}{57.05+0.81}=84.03 \%
\end{equation*}

\begin{equation*}
    \eta_{48 V}=\frac{50.72}{56.91+0.81}=87.87 \%
\end{equation*}

\begin{equation*}
    \eta_{1.04 Ohms}=\frac{94.45}{185.3+0.81}=50.74 \%
\end{equation*}

\begin{equation*}
    \eta_{4.16 Ohms}=\frac{24.04}{27.96+0.81}=87.05 \%
\end{equation*}

\begin{equation*}
    \eta_{6.24 Ohms}=\frac{16.69}{18.37+0.81}=87.05 \%
\end{equation*}

\begin{equation*}
    \eta_{8.32 Ohms}=\frac{12.55}{13.72+0.81}=86.37 \%
\end{equation*}

\tab As a result, we can say that efficiency increases in higher load resistances since we draw less current from the input side, meaning less losses on the resistive elements and smaller switching losses.

\section*{Thermal Design}
Thermal design is the one of the important part of design. For thermal design we have to model the system as electrical circuit. Electrical model of thermal heat flow is shown below. We assume that ambient temperature is 50C. 
\begin{figure}[H]
    \centering
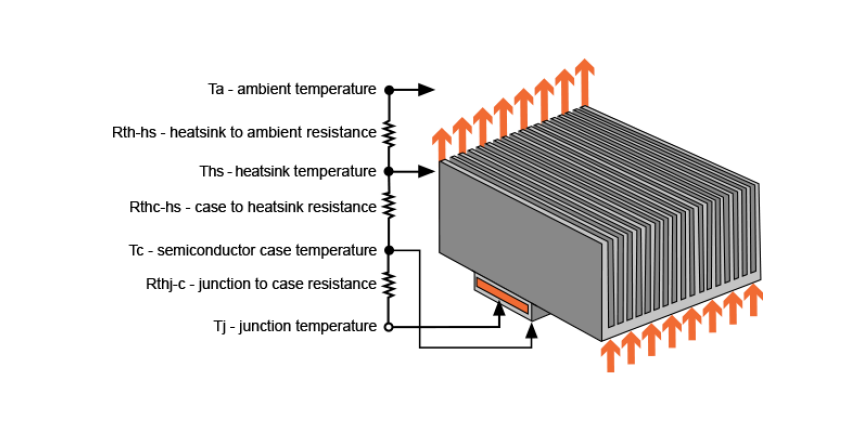
[picture p27: Final Report/termal.PNG]
    
    \caption{Thermal modelling}
    \label{fig:my_label}
\end{figure}
\subsection{Mosfet Thermal Design}
Mosfet heating rapidly due to the switching frequency. Mosfet heat transfer equivalent modelling shown below. 
\begin{figure}[H]
    \centering
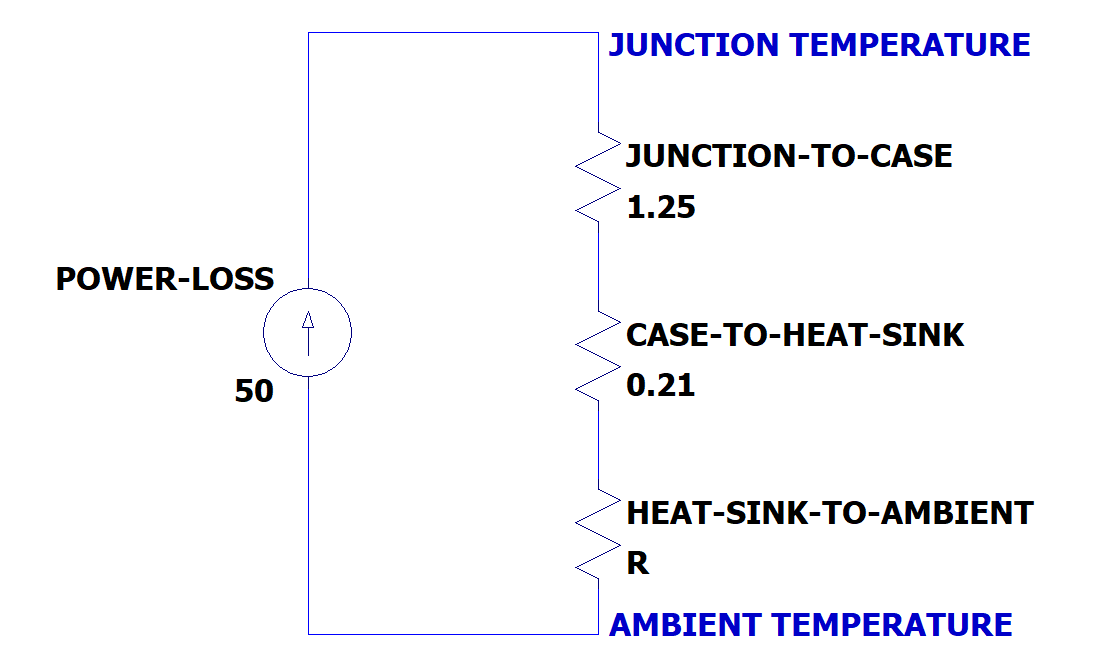
[picture p28: Final Report/MOSFETHEAT.PNG]
    
    \caption{Mosfet Thermal Modelling}
    \label{fig:my_label}
\end{figure}
\begin{equation}
    R_e_q=\frac{Junction Temperature-Ambient Temperature}{Power Loss}=\frac{130-50}{50}
\end{equation}
\begin{equation}
    R_e_q=1.6
\end{equation}
Heat sink to ambient is 1.6-1.25-0.21=0.14 C/W. Considering this, \href{https://www.boydcorp.com/aavid-datasheets/Board-Level-Cooling-Channel-5770.pdf}{577102B00000G} is selected as heatsink for MOSFET, whose thermal resistance is 0.20 C/W. Its package is TO220.Our MOSFET's package is TO-257AA, which is sutiable for TO220 thermal sinks to use. Its picture is given below:

\subsection{Diode Thermal Design}
Diode's heat do not increase as much as as MOSFET. Diode thermal equivalent model is shown below.
\begin{figure}[H]
    \centering
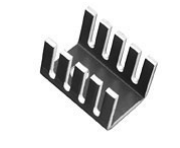
[picture p29: Final Report/mosfet_sink.PNG]
    
    \caption{Picture of MOSFET Heat Sink}
    \label{fig:my_label}
\end{figure}
\begin{equation}
    R_e_q=\frac{Junction Temperature-Ambient Temperature}{Power Loss}=\frac{130-50}{25}
\end{equation}
\begin{equation}
    R_e_q=3.2
\end{equation}
Heat sink to ambient is 3.2-2.25=0.95 C/W. According to this, \href{https://www.boydcorp.com/aavid-datasheets/Board-Level-Cooling-Extruded-5290.pdf}{530002B02500G} is selected for diodes. Package in this case is also TO220. Its picture is shown below:
\begin{figure}[H]
    \centering
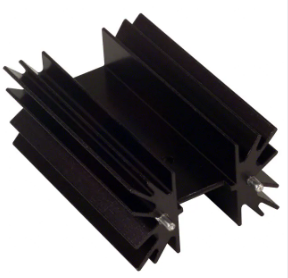
[picture p30: Final Report/diode_sink.PNG]
    
    \caption{Picture of the Diode Heat Sink}
    \label{fig:my_label}
\end{figure}

\section*{PCB Design, Bill of Materials and 3D View}
In PCB design we used Proteus design software. We chose Proteus because it has huge library and we worked with Proteus before.The package of chosen component are available on Proteus library. But transformer of the forward converter is not available on the library so there are holes for transformer block. We design inductor  and we will make our inductor with our hands so there is no package. Our design shown below. 
\begin{figure}[H]
    \centering
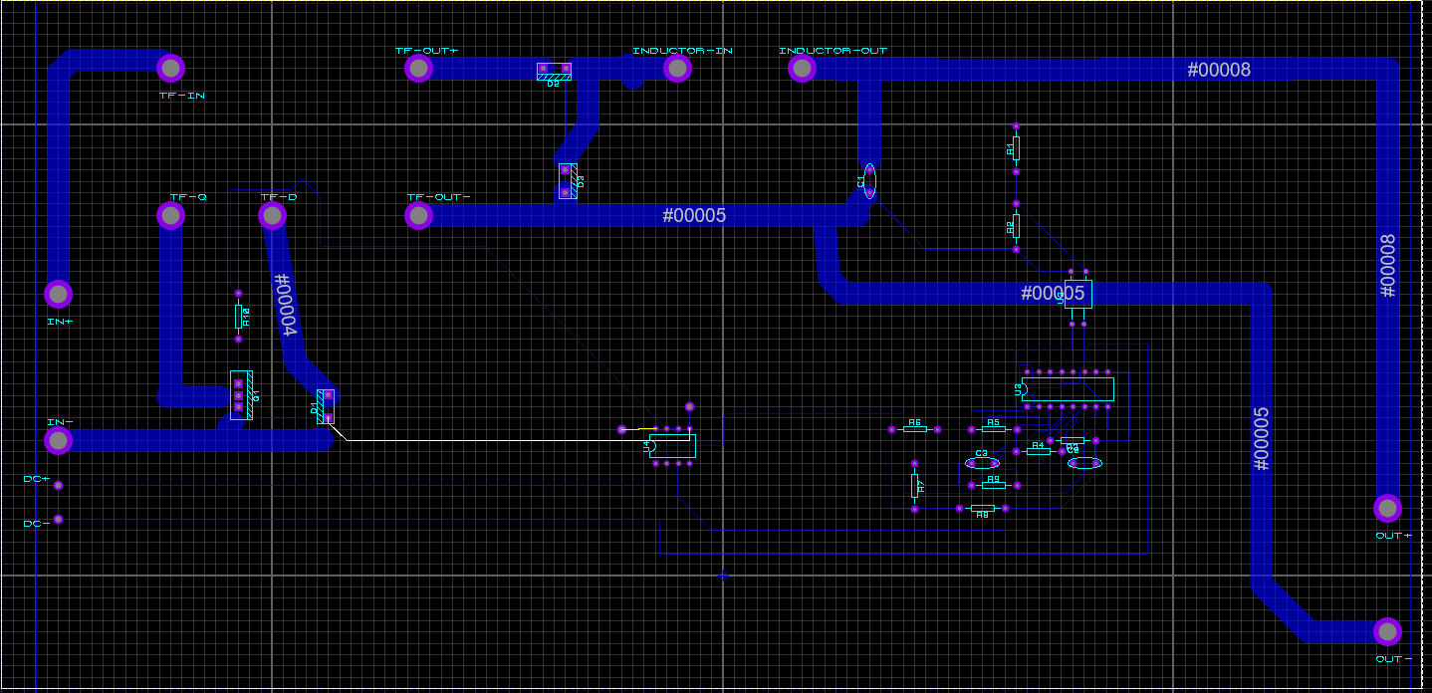
[picture p31: Final Report/pcby.PNG]
    
    \caption{PCB design of forward converter}
    \label{fig:my_label}
\end{figure}
For calculating we use Digikey PCB with calculator. For high power application I choose $4oz\ft^2$. 1 oz is 23.35g and $1ft^2$ is $0.093m^2$ so our max average current is 10 A so 5mm trace with ideal for design.Also Gerber files are uploaded to GitHub. 3D pc designs are shown below in figures. 
\begin{figure}[H]
    \centering
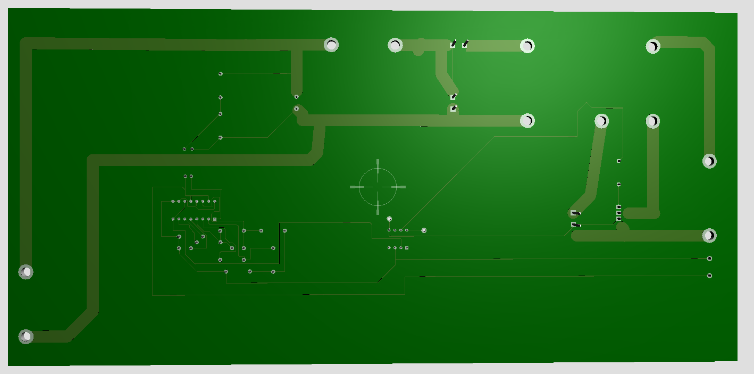
[picture p32: Final Report/arkapng.PNG]
    
    \caption{Back view of the design}
    \label{fig:my_label}
\end{figure}
\begin{figure}[H]
    \centering
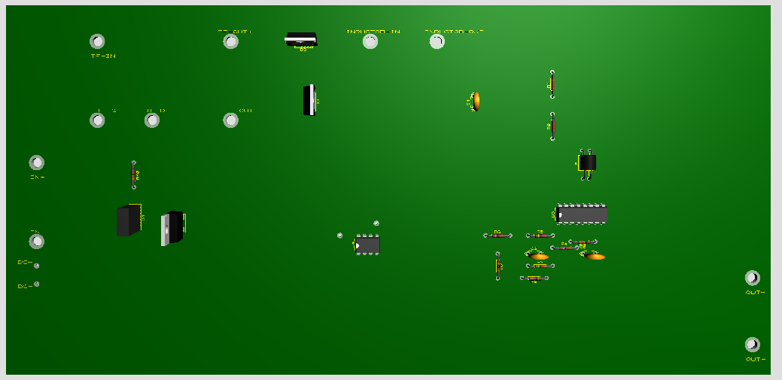
[picture p33: Final Report/3düst.PNG]
    
    \caption{Top view of the design}
    \label{fig:my_label}
\end{figure}
\begin{figure}[H]
    \centering
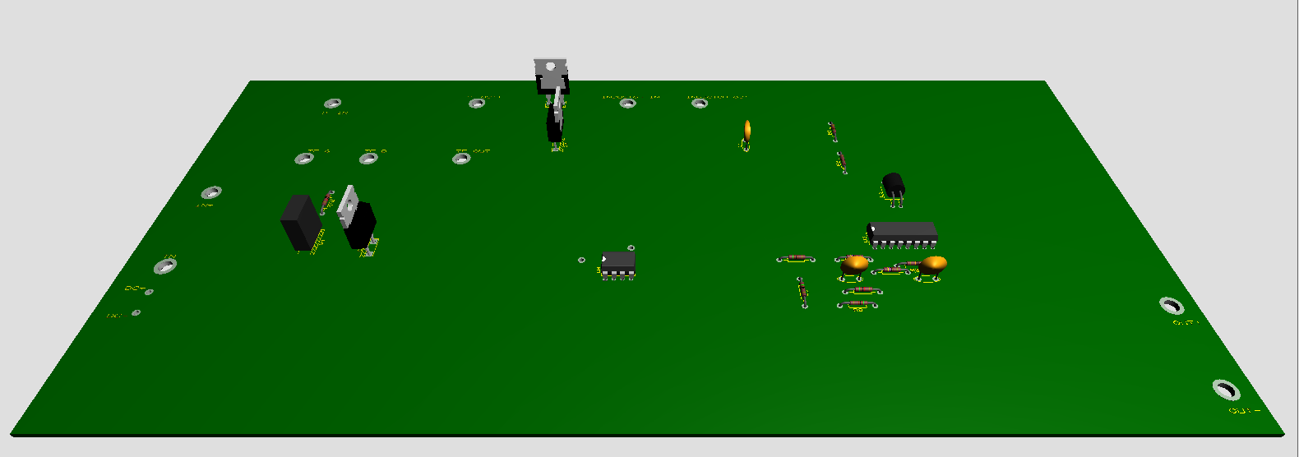
[picture p34: Final Report/3don.PNG]
    
    \caption{Front view of the design}
    \label{fig:my_label}
\end{figure}
\newpage
Bill of materials are shown below figure
\begin{figure}[H]
    \centering
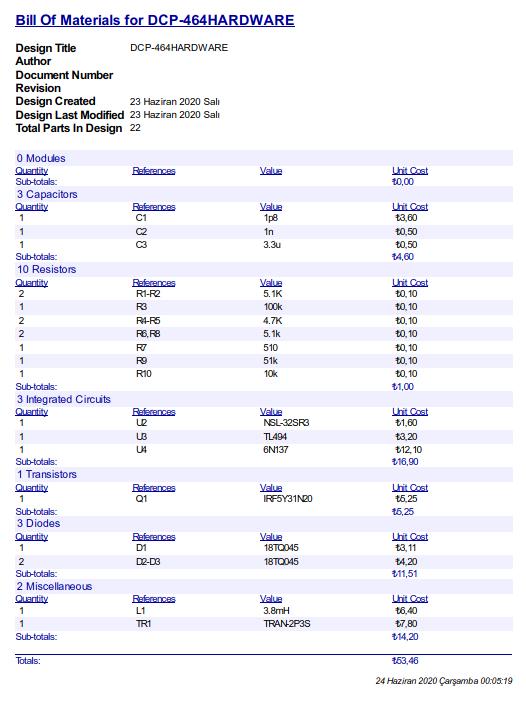
[picture p35: Final Report/bill.PNG]
    
    \caption{Front view of the design}
    \label{fig:my_label}
\end{figure}
\newpage
\section*{Conclusion}
\tab In this report, our hardware design specifications for Forward Converter are described. Although our main target was implementing this design and having an actual product on our hands at the end of the process, this was not possible due to recent pandemic. \\
\tab Nevertheless, our alternative approach for this project was really helpful since the project was covering a lot of steps that need to be done before creating an actual product in professional engineering. Using a more detailed simulation was teaching since as simulation gets more detailed, it gives us a better picture about what would actually happen if we tried to implement the project. We gained experience in PCB design which can be very helpful in professional engineering life since no customer wants to buy something built on stripboard. Using Bill of Material and 3D Viewer tools of the PCB design software gave us a better understanding about what would product actually look like how much it would cost more or less. Since these are critical in engineering product, they were also very beneficial. It was a useful experience covering lots of aspects of professional power electronics engineering.

\newpage
\section*{References}
\href{http://keysan.me}{http://keysan.me} \\
\href{https://www.mouser.com/pdfdocs/2-10.pdfhttps://www.mouser.com/pdfdocs/2-10.pdf}{https://www.mouser.com/pdfdocs/2-10.pdf} \\
\href{http://www.ti.com/lit/ds/symlink/tl494.pdf}{http://www.ti.com/lit/ds/symlink/tl494.pdf} \\
\href{https://320volt.com/tl494-smps-kontrol-entegresi-hakkinda/}{https://320volt.com/tl494-smps-kontrol-entegresi-hakkinda/} \\
\href{https://www.mag-inc.com/Media/Magnetics/Datasheets/0P44022EC.pdf}{https://www.mag-inc.com/Media/Magnetics/Datasheets/0P44022EC.pdf} \\
\href{https://www.mag-inc.com/Media/Magnetics/Datasheets/0W44715TC.pdf}{https://www.mag-inc.com/Media/Magnetics/Datasheets/0W44715TC.pdf} \\
\href{http://www.irf.com/product-info/datasheets/data/irf5y31n20.pdfhttp://www.irf.com/product-info/datasheets/data/irf5y31n20.pdf}{http://www.irf.com/product-info/datasheets/data/irf5y31n20.pdf} \\
\href{https://www.taiwansemi.com/products/datasheet/SFAF501G \%20SERIES_H1512.pdf}{https://www.taiwansemi.com/products/datasheet/SFAF501G \%20SERIES_H1512.pdf} \\
\href{https://www.taiwansemi.com/products/datasheet/SRA1020\%20SERIES_J13.pdf}{https://www.taiwansemi.com/products/datasheet/SRA1020\%20SERIES_J13.pdf} \\
\href{https://api.kemet.com/component-edge/download/specsheet/ESY477M035AH4AA.pdf}{https://api.kemet.com/component-edge/download/specsheet/ESY477M035AH4AA.pdf} \\

\end{document}
