m-zeybek/DPC-Hardware-Project/EE_464_HARDWARE SIMULATION REPORT.pdf

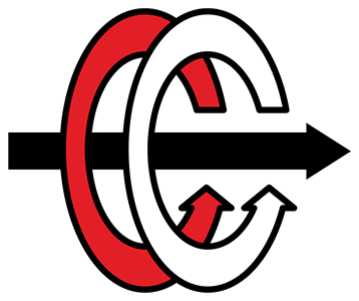
[picture p54: figure]

## MIDDLE EAST TECHNICAL UNIVERSITY

EE464- STATIC POWER CONVERSION-II

HARDWARE PROJECT SIMULATION REPORT

Mert ZEYBEK | 2167682
Hamza SOLAK | 2263762

Date: 23/03/2020

1

## Introduction

The aim of this project is to design a dc-dc converter with one of the two topologies. Topologies are flyback converter and forward converter, trade-offs between these topologies is discussed. When we are choosing our topology, we must examine the specification of the project. Every topology have some advantages and disadvantages. We must compare the advantages and disadvantages for choosing right topology.
After choosing our topology and project specifications, design details of projects are discussed including necessary components, integrated circuits, design of magnetic components with the help of simulation results in this report.

## Topologies

1)Flyback Converter

a)

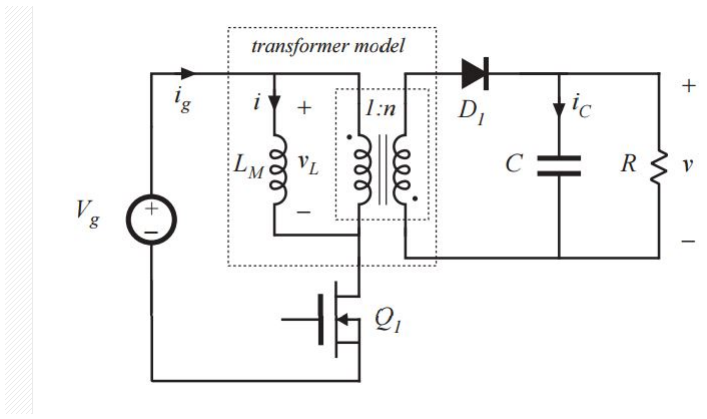
[picture p55: figure]

Figure 1: Flyback converter circuit schematic.

The flyback converter is based on the buck-boost converter.It is isolated buck-boost converter. Isolation provided with transformer.It is simple isolated converter. It’s input output relation is shown in the equation below.

Vo
Vd

=

D ∗ N2
(1 − D) ∗ N1

(1)

2


Figure 2: Forward converter circuit schematic

2) Forward Converter

It derived from buck converter.It uses transformer for increasing and decreasing output voltage. Transformer provides isolation between input and output.Forward converter’s input and output relation is shown equation below.

Vo
Vd

=

N2
N1
∗ D | (2)
3) Comparison Between Converter Topologies
a) Flyback Converter

Flyback converter have advantages over forward converter. It is cheaper than forward converter.It needs small voltage rating mosfet and change in the gain is small. We can design more compact circuit with flyback converter.

a) Forward Converter

Forward converter have advantages over flyback converter. It has better utilization of transformer. It provides higher power transformer. In design we can use gapless core. It provides us higher Lm and less ripple. Output inductor and diode ensure continuous output current. It also can provide higher efficiency.

We choose forward converter because in the specification we need less regulation and better utilization. Forward converter can provide these specifications. Since there is no cost and volume specification, its disadvantages are less important for our project.

3

## Design Decisions

1) Magnetic Design
a) Transformer Design
Our considerations regarding transformer was based on Converter Design Note Document by Infineon. (https://www.mouser.com/pdfdocs/2-10.pdf) We started with turn ratio decision considering the following formula:
Vo
Vi

=

n3
n1
D | (3)

Since we want D value to be smaller than 0.5 so that we do not charge the transformer core at each cycle. If D was larger than 0.5, it would saturate the core which is not desired.
As a result, we decided to have a n3
n1

= 1.2 which corresponds to 14.4 V at the output. Considering voltage drops on transistors, diodes and resistive parts of the elements, it will give a voltage less than 14.4 V at practice when minimum input voltage 24V is applied. So, at D close to 0.5, we expect to acquire 10 V output voltage. At maximum input voltage 48V , D value becomes
0.17. It will get smaller once the losses on the system are included. As a result, we get enough range of D to adapt to changes in input voltages. For the sake of simplicity, we chose n2 same as n1, which is usually the case in practical applications.
Next, we considered the following equation in order to avoid saturation of the core:
n1 >

Vimax

.Dmax
Bsat.Ae.fs

(4)

In order to have a meaningful result from this equation, we need to choose the transformer core so that we can put Bsat and Ae values in the equation. We selected to use an E core since their geometrical structure is suitable for three winding application. Considering the E cores that are available in the laboratory, we had two different types of cores, namely Kool Mu and Ferrite. Since we desire to have a high permeability core for Forward Converter, ferrite cores fit better for our application. Between ferrite cores, 0P45530EC (https://www.mag-inc.com/Media/Magnetics/Datasheets/0P45530EC.pdf) is the best solution since it has the largest window area. Although using large core means increase in cost, it ensures us that we are far from saturation and it also enables us to lower frequency, which means better efficiency, which is more important than cost in this project. We also need to select switching frequency. Since our core is large enough, selecting a relatively low frequency will increase efficiency and it will also ease semiconductor device selection. 10 kHZ switching frequency seems optimum for this case. As a result, minimum n1 value can be calculated as follows for core with Bsat = 0.3T and Ae = 420mm²
:

n1 >

48 ∗ 0.5
0.3 ∗ 420 ∗ 10⁻6 ∗ 10⁴

(5)

n1 > 19 | (6)

4

Since we do not want to increase copper losses, keeping n1 = 20 is the most suitable choice for our application. It also means that n2 = 20 and n3 = 24. Last thing to consider regarding transformer design is size of the cable. Choosing a cable with too small cross section would not have enough current carrying capability and resistance would be higher which would decrease efficiency. On the other hand, too large cross sectional area would result in too large fill factor.
AWG14, which has 2.08mm²
cross section area and 5.9A current carrying capability is suitable for our application. Fill factor calculation can be seen below:

kf =

n ∗ Acable
Ae

=

(24 + 20 + 20) ∗ 2.08mm²
420mm²
= 0.317 | (7)

Fill factor is small enough proper operation. As a result, AWG14 cable can be used at our transformer.

b) Output Inductor Design
At inductor design, we want to limit output current ripple which would also ensure continuous conduction mode. We want to keep the converter in CCM since forward converter’s gain changes a lot in DCM. On the other hand, choosing a too large inductor would increase DCR value, which would reduce efficiency. We considered following equations for calculation of our output inductor considering 2 % ripple rating:
ILO,min = IO,max ∗ 0.02 = 4.8 ∗ 0.02 = 0.096A | (8)

Ripple value must be less than twice of this value which is given below:

∆ILo = (n3
n1

∗ Vi − Vo) ∗

1
Lo
∗ ton < 0.192A | (9)

As a result, we need an inductor with 3.8mH inductance in order to meet criteria. This value is relatively high since our switching frequency is small but there are commercial products available at that value as well as we can wind one by ourselves.

2) Closed Loop Control

Closed loop control is critical in this application since we need supply fixed output voltage to load with changing input voltage. To achieve that, we need to have a feedback from output voltage and adjust duty cycle that drives the transistor accordingly. While doing that, we must not break isolation between input and output.
In order to achieve that we plan to use an analog integrated circuit, TL494. (http://www.ti.com/lit/ds/symlink/tl494.pdf) It enables us to control switching frequency with a single resistor and capacitor. TL494 also has soft start feature, which can be helpful for selecting semiconductor devices with smaller ratings because it helps us to avoid high

5

starting voltages and currents.
One thing to consider while using TL494 is it cannot directly be connected to transistor’s gate since it cannot supply enough current to turn on and off the transistor. TLP250 (https://pdf.direnc.net/upload/tlp250-datasheet.pdf) optocoupler connected between TL494 and transistor’s gate can solve the issue. For isolation purpose, feedback from the output voltage can also be taken using an optocoupler as well.
Another issue with TL494 usage is its supply voltage. In order to achieve our task with single power supply, we need to supply the IC from our input voltage. However, constant 15V needs to be supplied to the IC. We need to use a regulator for that purpose if we aim to achieve single supply bonus.

6

## Simulation Results and Component Selections

We built a Simulink model with our design decisions. For more detailed calculation and component selection, we simulated our topology and devices in Matlab Simulink. Our Matlab circuit schematic is shown in Figure 3.


Figure 3: Simulink simulation schematic

a) Firstly we simulate the case where the input is 48V and output is the 10V. Simulation results are shown below.


Figure 4: Output waveform when input is 48V

Output must be constant at 10V. When input is equal to 48V Our

7

duty cycle must be smallest value due to the specifications.Our smallest duty cycle is %17.584. %17.584 duty cycle give us 10V when input is 48V.Signal statistics of the output waveform is shown below.

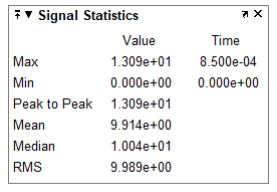
[picture p56: figure]

Figure 5: Output waveform signal statistics when input is 48V

In design and component selection currents are important. For choosing current rating of devices we observe currents of devices. Current and voltage waveform of the mosfet shown below.


Figure 6: Voltage and current wave forms of mosfet when input 48V

Duty cycle signal statistics are shown below.

8

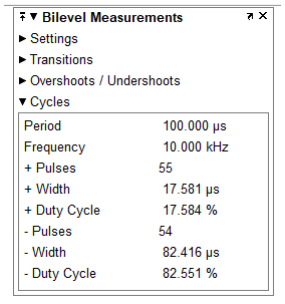
[picture p57: figure]

Figure 7: Duty cycle signal information when input is equal to 48V

We measure also diodes voltages and currents because diodes ratings are also important.Diodes currents and voltages shown below.


Figure 8: Voltage and current wave forms of diode 1 when input 48V

9


Figure 9: Voltage and current wave forms of diode 2 when input 48V


Figure 10: Voltage and current wave forms of diode 3 when input 48V

We also measure the output capacitor voltages and current for component selection

10

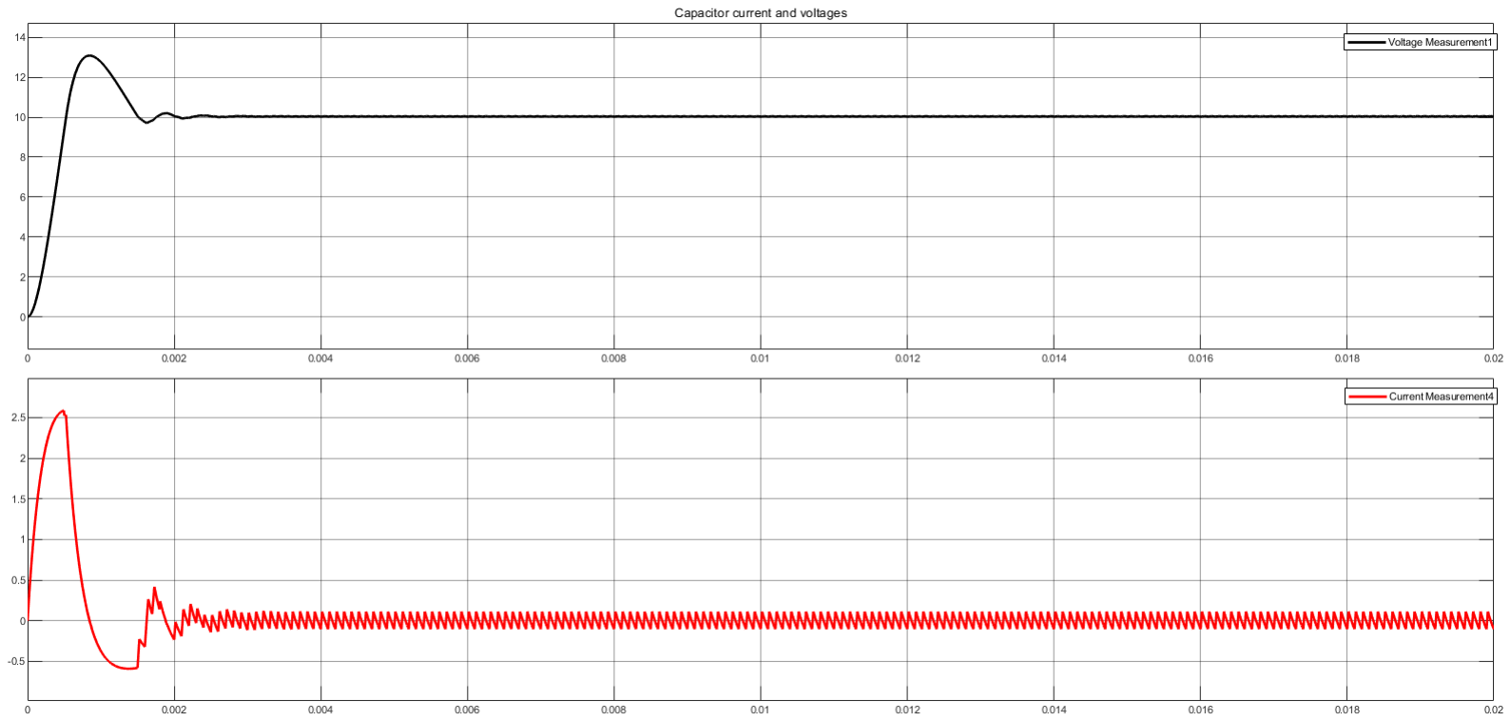
[picture p58: figure]

Figure 11: Voltage and current wave forms of capacitor when input 48V

b) We simulated circuit when input is equal to 24V. We simulate extreme point of the specifications. Output wave form of the converter shown below.


Figure 12: Output waveform when input is 24V

When input is equal to 24V, our duty cycle must be at the highest value due to the specifications.Our highest duty cycle is %34.250. %34.250 duty cycle give us 10V when input is 24V.Signal statistics of the output waveform is shown below.

11

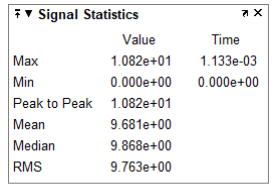
[picture p59: figure]

Figure 13: Output waveform signal statistics when input is 24V


Figure 14: Voltage and current waveforms of mosfet when input 24V

According to simulation results, mosfet should be capable of handling 96V drain to source voltage and 6A current. As a result, we chose IRF540 N (https://pdf.direnc.net/upload/irf540nspbf-datasheet.pdf) as our transistor with 100V and 27A ratings.
When input is equal to 24V duty cycle signal information shown below.

12


Figure 15: Duty cycle signal information when input is equal to 24V

When input equal to 24V diodes voltages and currents are shown below.


Figure 16: Voltage and current waveforms of diode 1 when input 24V

13


Figure 17: Voltage and current waveforms of diode 2 when input 24V


Figure 18: Voltage and current wave forms of diode 3 when input 24V

Diodes on the output side have same voltage and current stresses, which are 58V and 6A. Diode on the input side has 96V and 2.5A ratings. We decided to use same MBR20100 (https://www.direnc.net/mbr20100-diyot--20a-100v-dual-high-voltage-schottky) diode for all of them whose ratings are 100V and 20A. Since this diode is Schottky it is beneficial to use it since there is no recovery time in Schottky diodes.

14


Figure 19: Voltage and current wave forms of capacitor when input 24V

In capacitor selection, we desired to have a capacitor with a high capacitance rating so that it can reduce output voltage ripple to desired levels and we also wanted it to withstand the output voltage with a safe difference between capacitor rating and output voltage. Another thing we considered is minimizing the ESR value since we do not want to reduce our efficiency. As a result, ESC107M016AC3AA (https://www.digikey.com/product-detail/en/kemet/ESC107M016AC3AA/399-6080-ND/2712569) is selected. It has 100F capacitance and 16V voltage rating. Its ESR value is specified as 900mOhm at 100KHz. We expect it to be lower at our case since our switching frequency is 10KHz.

15

## Conclusion

In this report, we specified our decisions and plans to build a Forward Converter which can meet the criteria that are specified in project definition.Firstly, we made some calculations considering our design specifications and then we simulated our design and observed stresses on the components, non-ideal behaviors of them and how they affect our requirements.
To conclude, we believe this report is going to be helpful once we start to implement our design since we considered not only ideal case like in the simulation, but also many non-ideal situations such as fill factor, saturation of the core etc. We became more prepared for the actual project with the help of this report.

16
