m-zeybek/DPC-Hardware-Project/hardwarepcb/3d.pdf

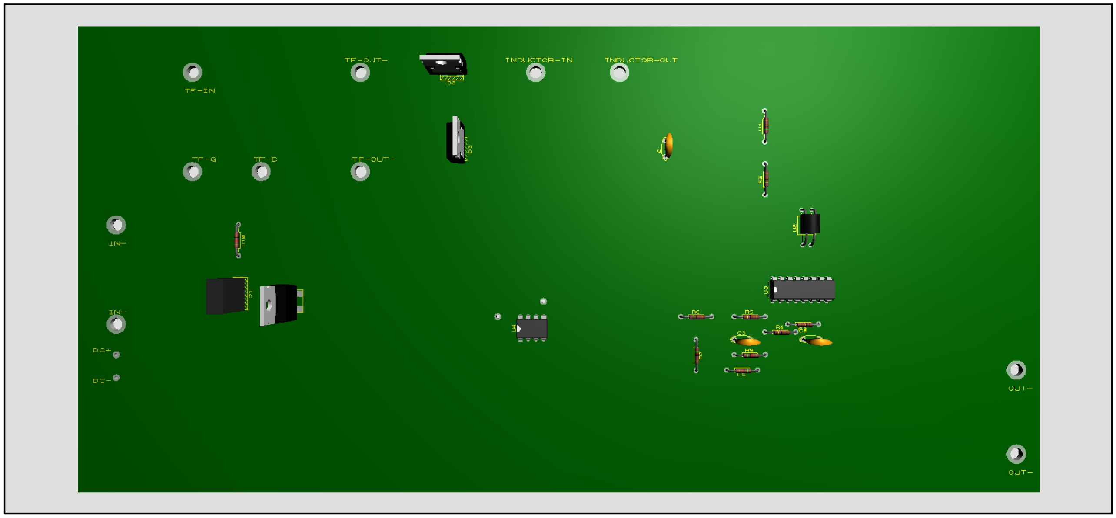
[picture p74: figure]
