m-zeybek/DPC-Hardware-Project/diodeheat.PNG

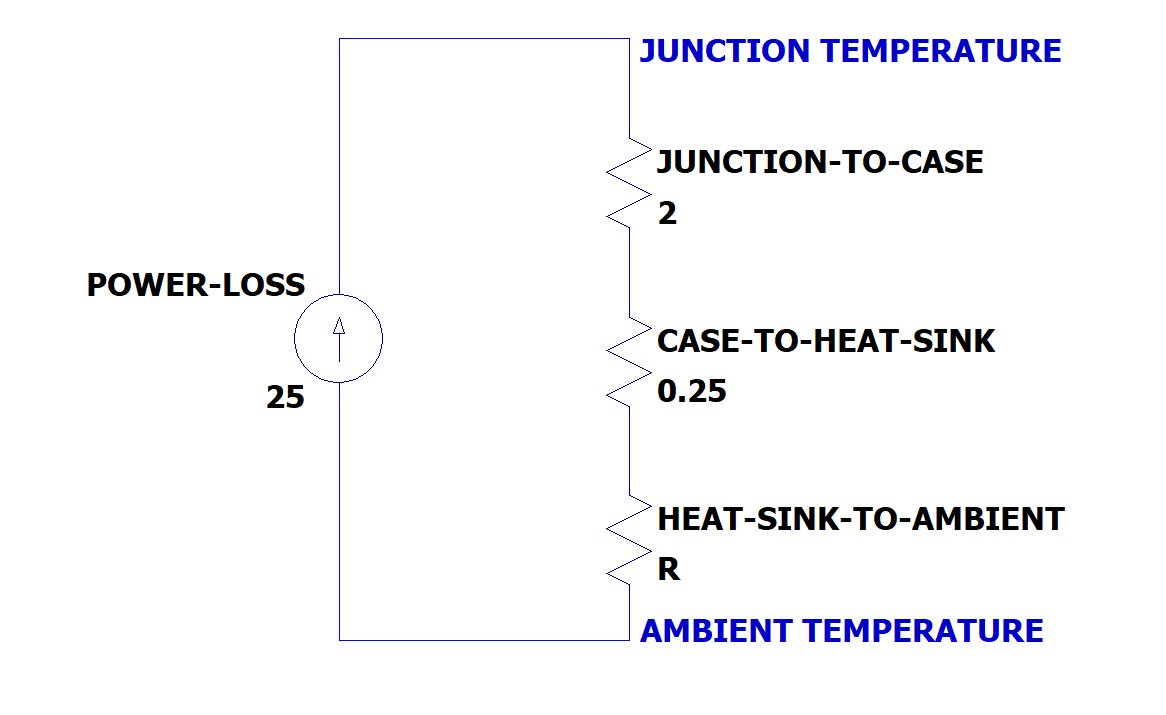
diodeheat.PNG
