m-zeybek/DPC-Hardware-Project/EE 464 HARDWARE/out24.png

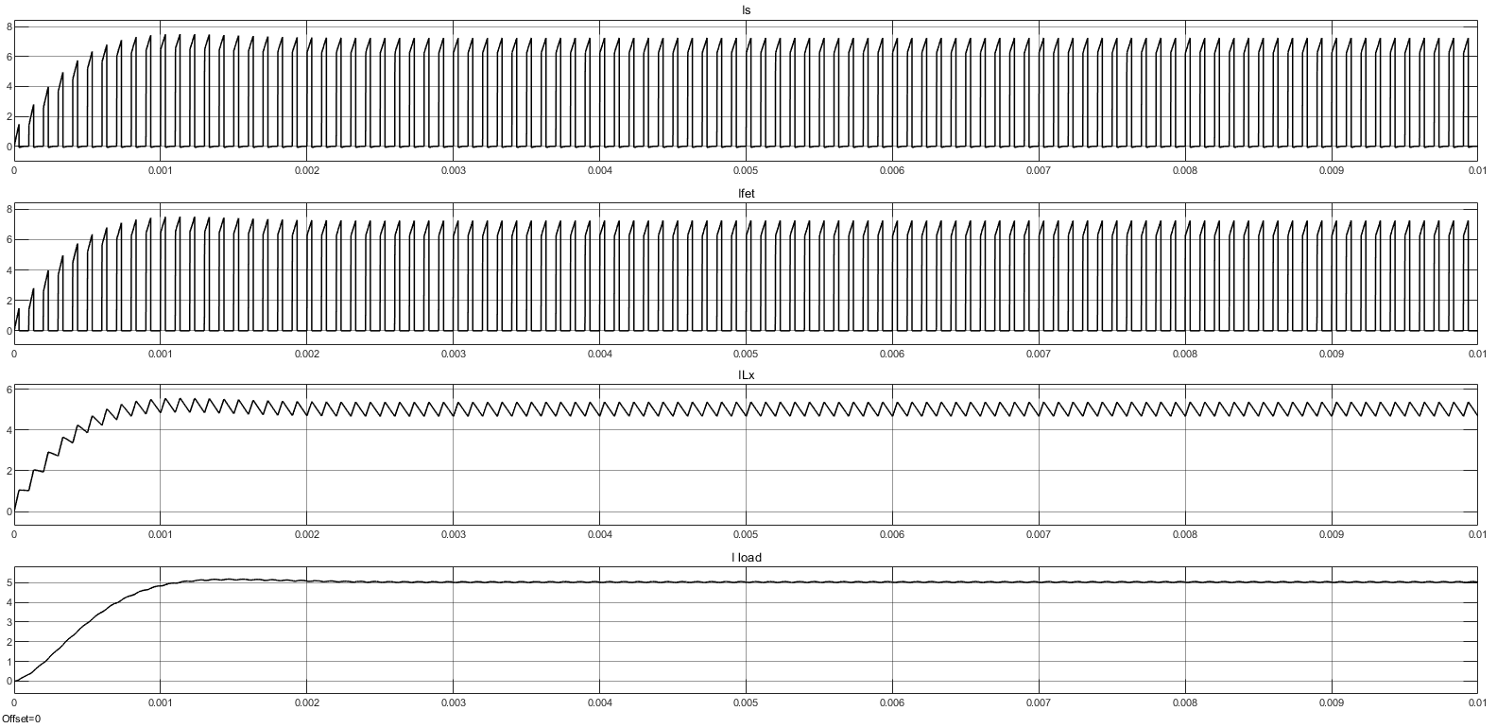
EE 464 HARDWARE/out24.png
