m-zeybek/DPC-Hardware-Project/EE 464 HARDWARE/out48.png

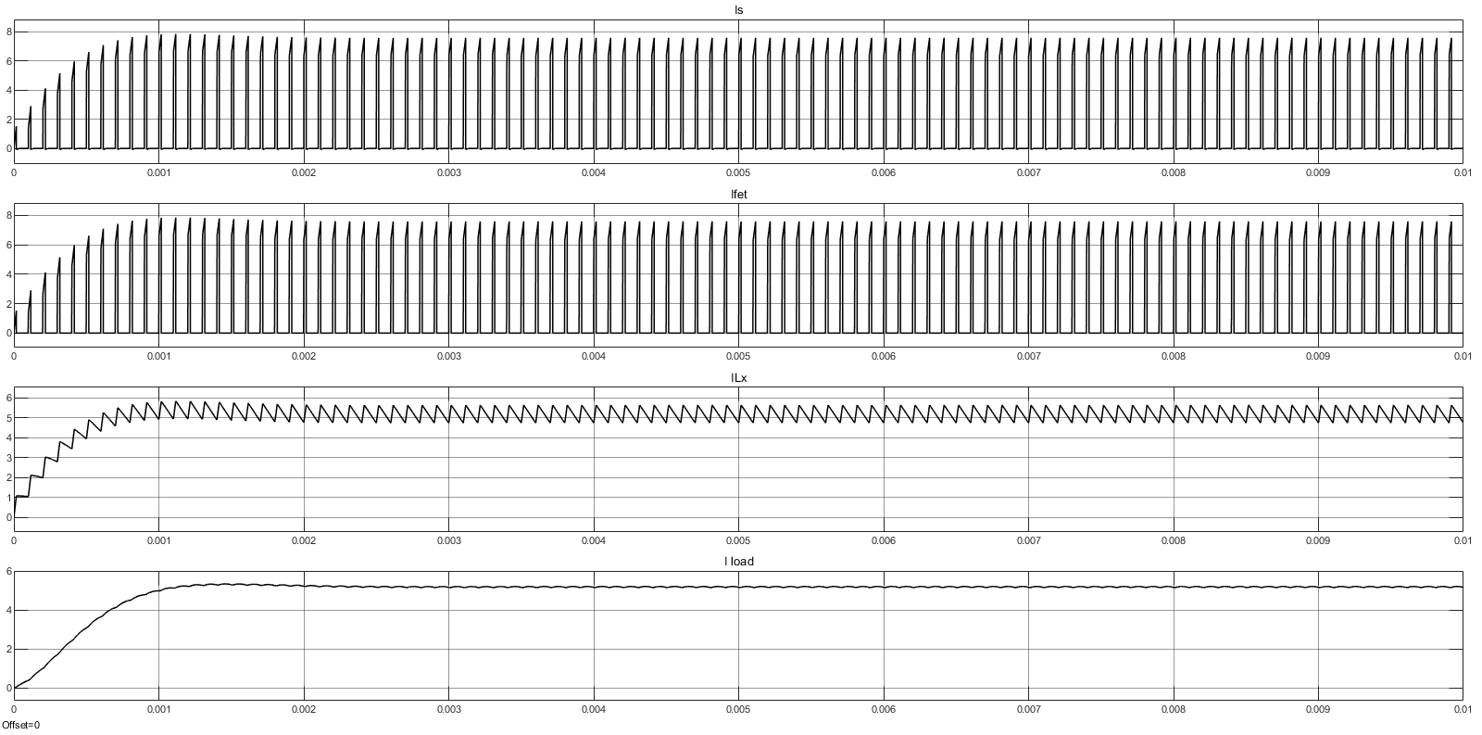
EE 464 HARDWARE/out48.png
