m-zeybek/DPC-Hardware-Project/Final Report/analog opto.PNG

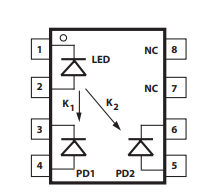
Final Report/analog opto.PNG
