m-zeybek/DPC-Hardware-Project/Final Report/buck.PNG

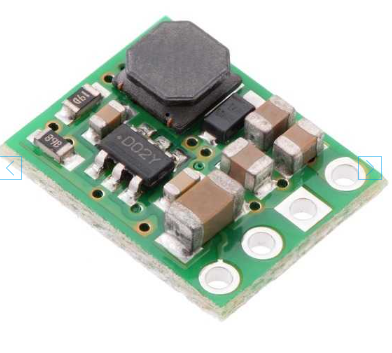
Final Report/buck.PNG
