m-zeybek/DPC-Hardware-Project/hardwarepcb/Bill Of Materials DCP-464HARDWARE.pdf

## Bill Of Materials for DCP-464HARDWARE

Design Title | DCP-464HARDWARE

### Author Document Number Revision

Design Created | 23 Haziran 2020 Salı

### Design Last Modified 23 Haziran 2020 Salı Total Parts In Design 22

0 Modules
Quantity | References | Value | Unit Cost
Sub-totals: | | | ₺0,00
3 Capacitors
Quantity | References | Value | Unit Cost
1 | C1 | 1p8 | ₺3,60
1 | C2 | 1n | ₺0,50
1 | C3 | 3.3u | ₺0,50
Sub-totals: | | | ₺4,60
10 Resistors
Quantity | References | Value | Unit Cost
2 | R1-R2 | 5.1K | ₺0,10
1 | R3 | 100k | ₺0,10
2 | R4-R5 | 4.7K | ₺0,10
2 | R6,R8 | 5.1k | ₺0,10
1 | R7 | 510 | ₺0,10
1 | R9 | 51k | ₺0,10
1 | R10 | 10k | ₺0,10
Sub-totals: | | | ₺1,00
3 Integrated Circuits
Quantity | References | Value | Unit Cost
1 | U2 | NSL-32SR3 | ₺1,60
1 | U3 | TL494 | ₺3,20
1 | U4 | 6N137 | ₺12,10
Sub-totals: | | | ₺16,90
1 Transistors
Quantity | References | Value | Unit Cost
1 | Q1 | IRF5Y31N20 | ₺5,25
Sub-totals: | | | ₺5,25
3 Diodes
Quantity | References | Value | Unit Cost
1 | D1 | 18TQ045 | ₺3,11
2 | D2-D3 | 18TQ045 | ₺4,20
Sub-totals: | | | ₺11,51
2 Miscellaneous
Quantity | References | Value | Unit Cost
1 | L1 | 3.8mH | ₺6,40
1 | TR1 | TRAN-2P3S | ₺7,80
Sub-totals: | | | ₺14,20
Totals: | | | ₺53,46
| | | 24 Haziran 2020 Çarşamba 00:05:19
