m-zeybek/DPC-Hardware-Project/hardwarepcb/pcb.pdf

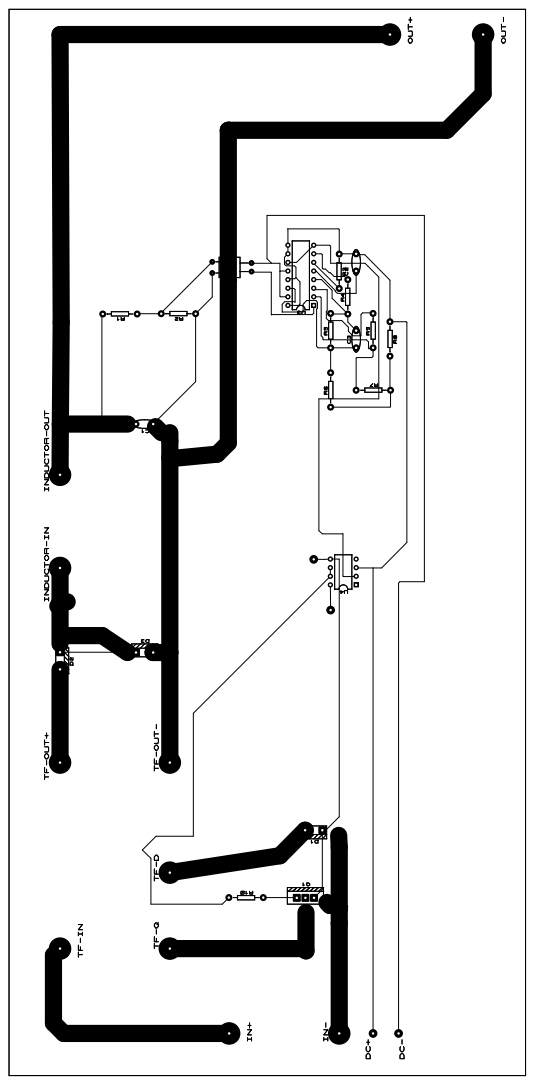
[picture p80: page 1]
