m-zeybek/DPC-Hardware-Project/(list of files, drawings)

Other design files:
hardwarepcb/DCP-464HARDWARE.pdsprj
YENİ.pdsprj
