m-zeybek/DPC-Hardware-Project/(commit log)

2020-06-15 Magnetic design is revisited
2020-06-16 Controller circuit is revised
2020-06-22 proteus dizayn
    [YENİ.pdsprj]
2020-06-23 pcb p
2020-06-23 yeni pcb 3boyut
    [DCP-464HARDWARE.pdsprj]
2020-06-23 bill of materials
2020-06-23 allpcb files
    [DCP-464HARDWARE.pdsprj]
2020-06-23 geber dosyaları üretim için
    [DCP-464HARDWARE - CADCAM Bottom Copper.GBR, DCP-464HARDWARE - CADCAM Bottom Solder Resist.GBR, DCP-464HARDWARE - CADCAM Drill TOP-BOT Plated.GBR, DCP-464HARDWARE - CADCAM Mechanical 1.GBR, DCP-464HARDWARE - CADCAM Top Assembly.GBR, DCP-464HARDWARE - CADCAM Top Copper.GBR, DCP-464HARDWARE - CADCAM Top Silk Screen.GBR, DCP-464HARDWARE - CADCAM Top Solder Resist.GBR]
